Michael314as/Exoskelett/docs/kraftverteilung.md

# Kraftverteilung (Entwurf 4)

Grobe statische Abschätzung: Welche Kräfte entstehen beim Aufladen und Schleifen, über welche
Teile laufen sie in den Boden und wie viel davon kann das Exo übernehmen.
Gerechnet mit [`tools/kraftverteilung.py`](../tools/kraftverteilung.py) (Seitenansicht, ohne
Schwung, Baumgewichte „typische Nordmanntanne“; echte Bäume streuen stark).

Die Zahlen sind **Größenordnungen** für die Auslegung, keine Vorhersage für jeden Baum.

---

## 1. Kraftfluss: welcher Weg die Last nimmt

```
Stamm
 └─ Zahnleiste + Schlaufen am Handgelenk (rechts 2, links 1)
     └─ Schlaufenkopf (Alu, an der Unterarmschiene verschraubt)
         └─ Unterarmschiene ── Ellbogengelenk (Motor über Bowdenzug-Paar)
             └─ Oberarmschiene ── Schultergelenk (Motor über offenes Seilpaar)
                 └─ Schulterbügel ── Rückenrahmen
                     └─ Hüftbügel ── Hüftgelenk (Motor über Beinseil)
                         └─ Oberschenkelschiene ── Kniegelenk (gleiches Beinseil)
                             └─ Unterschenkelschiene ── Sprunggelenk (frei)
                                 └─ Steigbügel unter dem Schuh ── Boden
```

Wichtig für die Steuerung: **Die blauen Manschetten liegen nicht in diesem Weg.** Die Last des
Baums geht über die Schlaufen direkt in die Schienen. Die Manschetten spüren nur, was dein
Körper gegen das Exo drückt – also deine Absicht. Dazu mehr in [steuerung.md](steuerung.md).

Wo die Last am Körper ankommt:
- **Hüftgurt:** nimmt das Gewicht von Rahmen, Akku und Motoren (rund 10 kg) und, wenn die
  Beinmotoren nicht schieben, auch die Last aus den Armen.
- **Exo-Beine:** bei fast gestreckten Knien tragen die Schienen die Last fast ohne Motorkraft
  in den Steigbügel. In der Hocke trägt nur, was die Beinmotoren an Moment aufbringen.
- **Deine Arme** spüren nur den Teil, den das Exo nicht übernimmt.

---

## 2. Lasten je Arbeitsschritt

„Kraft je Arm“ ist die Kraft am stärker belasteten Arm, „je Schlaufe“ teilt sie rechts auf zwei
Schlaufen, links auf eine (beim Aufrichten hebelt links die Hand). Momente sind die **Zusatzmomente durch den Baum** (das Eigengewicht von Körper und
Exo kommt dazu). „Schwerpunkt vor Knöchel“: Liegt der Wert über etwa 20 cm, kippt man ohne
Ausfallschritt nach vorne (Schuh reicht etwa 20 cm vor den Knöchel).

| Schritt | Baum | Kraft je Arm (N) | je Schlaufe (N) | Ellbogen je Arm (Nm) | Schulter je Arm (Nm) | Hüfte beide (Nm) | Knie beide (Nm) | Schwerpunkt vor Knöchel (cm) |
| --- | --- | --- | --- | --- | --- | --- | --- | --- |
| Aufrichten 2 m | 15 kg | 92 | 92 | 27 | 28 | 54 | 33 | 9 |
| Aufrichten 3 m | 41 kg | 361 | 361 | 104 | 108 | 212 | 129 | 21 |
| Aufrichten 4 m | 85 kg | 960 | 960 | 277 | 288 | 564 | 343 | 35 |
| Tragen 2 m | 15 kg | 147 | 74 | 15 | 37 | 21 | 6 | -3 |
| Tragen 3 m | 41 kg | 402 | 201 | 42 | 101 | 57 | 17 | -1 |
| Tragen 4 m | 85 kg | 834 | 417 | 87 | 208 | 118 | 35 | 0 |
| Hochheben 2 m | 15 kg | 147 | 74 | 30 | 47 | 29 | 17 | -2 |
| Hochheben 3 m | 41 kg | 402 | 201 | 83 | 129 | 78 | 47 | 1 |
| Hochheben 4 m | 85 kg | 834 | 417 | 171 | 267 | 162 | 97 | 3 |
| Schleifen 2 × 2 m | 15 kg | 107 | 53 | 19 | 11 | 13 | 23 | -4 |
| Schleifen 3 × 2 m | 15 kg | 213 | 107 | 39 | 23 | 19 | 35 | -6 |
| Schleifen 2 × 3 m | 41 kg | 296 | 148 | 52 | 28 | 35 | 60 | -9 |

Annahmen der Schritte:
- **Aufrichten:** Schnittende steht am Boden (Drehpunkt), linker Unterarm hebt etwa 90 cm weiter
  oben, Baum bei 15°. Hocke, Rumpf vorgeneigt.
- **Tragen:** Baum fast senkrecht, rechter Unterarm steil nach oben wie eine Fackel, linker stützt nur seitlich.
- **Hochheben:** Schnittende auf etwa Brusthöhe.
- **Schleifen:** Arme hängen, Stümpfe am Handgelenk (rechts bis zu zwei, links einer), Spitzen schleifen über nassen Schnee
  oder Schlamm (Reibwert 0,7, eher hoch angesetzt).

---

## 3. Was die Antriebe schaffen

Motor-Klasse „Robotergelenk mittel“ (etwa 9 Nm dauernd, 25 Nm Spitze am Abtrieb), Seiltrommel
Ø 3 cm. Je Körperseite, nach Reibungsverlusten (Bowdenzug 30 %, offenes Seil über Rollen 10–12 %):

| Gelenk | Übersetzung | Dauer (Nm) | Spitze (Nm) |
| --- | --- | --- | --- |
| Schulter | Seilscheibe Ø 14 cm, offenes Seilpaar | 37 | 103 |
| Ellbogen | Seilscheibe Ø 10 cm, Bowdenzug-Paar | 21 | 58 |
| Hüfte | eigener Motor an der Hüftschwinge, Seilgetriebe 1:6 (Trommel Ø 2 / Scheibe Ø 12 cm) | 47 | 140 |
| Knie | Bowdenzug-Paar, Kurvenscheibe 5 cm gestreckt bis 8 cm in der Hocke | 21–31 | 58–95 (gestreckt) bis 115 (Hocke, Spitze) |

### Entwurf 4: Mischweg an der Hüfte (gerechnet und entschieden)

Bedarf je Seite in tiefer Hocke beim Aufrichten eines 3-m-Baums: Hüfte etwa 45 Nm (Körper) + 106 Nm (Baum) ≈ 150 Nm,
Knie etwa 33 + 65 ≈ 100 Nm. Soll das Exo die Hälfte tragen: Hüfte ≈ 75 Nm, Knie ≈ 50 Nm.

| | ein Seil pro Bein (Entwurf 3.2) | Mischweg (Entwurf 4) |
|---|---|---|
| Hüfte Spitze | ~140 Nm | ~140 Nm |
| Knie Spitze | ~120 Nm | ~95–115 Nm |
| Hüfte und Knie getrennt regelbar | nein (festes Verhältnis 1,2 : 1) | **ja** |
| Spreizen | Seile durch hohle Achse, 4 Umlenkrollen | Motor spreizt mit, nur ein biegsamer Bowdenzug fürs Knie |
| Motoren | 6 | 8 (+300 bis 1 000 €, +1,5 bis 2 kg nah am Schwerpunkt) |

Entscheidend war nicht die Kraft (beide Wege reichen), sondern dass Hüfte und Knie in beide Richtungen getrennt geregelt
werden können: Nur so läuft das Bein beim Gehen frei mit und das Exo-Bein lässt sich je Gelenk sauber ausgleichen.
Ein Hüftmotor ohne Seilgetriebe reicht nicht (25 Nm); ein Motor mit großem Getriebe wäre stark genug, ließe sich aber
nicht mehr leicht von Hand bewegen.

Gegenüber Entwurf 3 bringt die neue Seilführung an der Schulter rund 25 % mehr (offenes Seil statt Bowdenzug) und
am Knie in der Hocke rund 33 % mehr (Kurvenscheibe statt fester Rolle), ohne stärkere Motoren. Dazu kommt das Seil
nicht mehr an die Gelenke: Vorher lief es in tiefer Hocke durch das Kniegelenk, und der Hebel an der Hüfte schrumpfte.

Seilkraft bei Motorspitze: etwa 1.700 N. Dyneema 3 mm hält ein Vielfaches; Bowden-Innenzug
deshalb **2 mm Edelstahl 7 × 7 oder Dyneema in PTFE-Hülle**, Software begrenzt auf etwa 1.000 N.

### Bewertung

| Bereich | 2 m | 3 m | 4 m |
| --- | --- | --- | --- |
| Schultern | Exo kann alles übernehmen | Exo übernimmt fast alles bis drei Viertel | Exo hilft spürbar (rund ein Drittel bis die Hälfte), Rest du |
| Ellbogen | Exo kann alles übernehmen | beim Tragen fast alles, beim Aufrichten gut die Hälfte | ein Fünftel (Aufrichten) bis zwei Drittel (Tragen) |
| Hüfte, Knie | locker | Exo übernimmt die Hälfte oder mehr | beim Aufrichten etwa die Hälfte, beim Tragen das meiste |
| Schleifen | kaum Moment, Last hängt an den Schultern | dito | dito |

Daraus folgt:
1. **Die Schultern sind der Engpass**, sobald der Baum vor dem Körper hängt. Weil der Stamm jetzt als
   Verlängerung des Unterarms am Handgelenk hängt, trägt man ihn am besten mit **steil aufgerichtetem
   Unterarm, wie eine Fackel**: Dann drückt die Last fast längs durch Unterarm und Ellbogen, und der
   Ellbogen muss kaum Moment halten. Möglichst nah am Körper; die linke Hand stützt weiter oben.
   Beim Aufrichten (Unterarm flach) ist dagegen der Ellbogen stark gefordert, dort helfen die Beine.
2. **Beine und Hüfte** sind gut versorgt. Das ist gewollt: Aufrichten und Hochheben kommen am
   besten aus den Beinen, wie beim richtigen Heben.
3. **Schleifen ist für das Exo leicht:** Mit hängenden Armen zieht die Last fast nur in
   Längsrichtung an den Schienen, die Gelenke müssen kaum Moment halten. Die Last landet über
   den Rahmen auf Hüftgurt und Exo-Beinen statt auf deinen Schultern.
4. **Gleichgewicht:** Beim Aufrichten schwerer Bäume (3–4 m) liegt der Schwerpunkt vor der
   Schuhspitze. Ohne verlängerte Fußplatten heißt das: **Ausfallschritt**, also einen Fuß nach vorne,
   und mit den Beinen hochdrücken. Das macht man ohnehin intuitiv. Beim Tragen, Hochheben und
   Schleifen bleibt der Schwerpunkt über dem Fuß.
5. **Schlaufen:** typisch 50–200 N je Schlaufe, im Extremfall rund 500 N (rechts verteilt auf zwei
   Schlaufen). Mit Zahnleiste im Schlaufenkopf hält der Stamm formschlüssig und nicht nur über Reibung.

---

## 4. Wie viel spürst du noch?

Die Steuerung verstärkt deine Kraft mit einem einstellbaren Faktor K (siehe
[steuerung.md](steuerung.md)). Solange die Motoren nicht an ihrer Grenze sind, gilt:

| K | Exo übernimmt | du spürst |
| --- | --- | --- |
| 0,5 | ein Drittel | zwei Drittel |
| 1 | die Hälfte („doppelte Kraft“) | die Hälfte |
| 2 | zwei Drittel | ein Drittel |
| 3 | drei Viertel | ein Viertel |

Start mit K = 0,5, dann steigern. Über K = 3 wird das Exo unruhig und man spürt die Last
kaum noch, was gefährlich ist: Man merkt nicht mehr, wenn etwas zu schwer wird.

---

## 5. Folgen für die Konstruktion

- Schulter- und Ellbogengelenke mit **großer Seilscheibe** (Ø 10–14 cm), Schulter mit offenem Seilpaar,
  weil dort am meisten Moment gebraucht wird. Bowdenzug nur dort, wo ein Seil über mehrere bewegte
  Gelenke müsste (Ellbogen).
- **Seilscheiben auf den Gelenkachsen** statt Rollen daneben: konstanter Hebel, das Seil kommt nie ans
  Gelenk. Am Knie eine Kurvenscheibe, die in der Hocke den größten Hebel gibt.
- Jede Rolle kostet ein paar Prozent: so wenige wie möglich, Kugellager, Durchmesser mindestens
  10 × Seildicke.
- Schlaufenkopf und Unterarmschiene **biegesteif** (Alu 25 × 25 × 2), denn bis zu rund 1.000 N greifen
  hier außermittig an.
- Schulterbügel und Rahmen-Eckverbindungen mit **Doppelplatten**, dort sammelt sich die Last
  beider Arme.
- Hüftgurt wie bei einer Lastenkraxe: Er muss beim Schleifen 20–45 kg zusätzlich aufnehmen
  können, wenn die Beinmotoren aus sind.
- Steigbügel unter der **Schuhmitte** (nicht unter der Ferse), damit die Last der Schienen dort ankommt,
  wo du ohnehin stehst.
