Michael314as/Exoskelett/docs/wartung.md

# Wartung

Die Firmware zählt die Betriebsstunden und meldet in der Statuszeile bzw. in der Konsole (`status`), wenn etwas fällig ist.

| Wann | Was | Wie |
|---|---|---|
| vor jedem Einsatz | Sichtprüfung | Seile ohne Scheuerstellen, Schnallen, Spikes fest, Not-Aus kurz testen |
| nach jedem Einsatz | trocknen | Box öffnen, Polster abnehmen und trocknen, Harz abwischen |
| alle 40 h | Seile und Bowdenzüge | auf Abrieb prüfen, Vorspannung nachstellen, Rollen auf Leichtgang prüfen |
| alle 40 h | Schrauben | Gelenk-Passschrauben mit Drehmomentschlüssel nachziehen (M10: 20 Nm, M6: 8 Nm) |
| alle 100 h | Wägezellen | Nullpunkt und ein Kalibriergewicht prüfen (`null`, `kal`) |
| alle 200 h oder jährlich | Inspektion | Beinseile tauschen, Lager prüfen (Spiel, Geräusch), Schlaufenschläuche tauschen, Prüfprotokoll P5–P20 wiederholen |
| bei Bedarf | Spikes | auf hartem Boden abschrauben, stumpfe tauschen |

**Verschleißteile auf Vorrat:** 10 m Dyneema 3 mm, 2 Bowden-Innenzüge, 3 Schlaufenschläuche, 10 Spikes, 4 Gummipuffer.
