Michael314as/Exoskelett/fertigung/druck/manschette_schienbein.stl

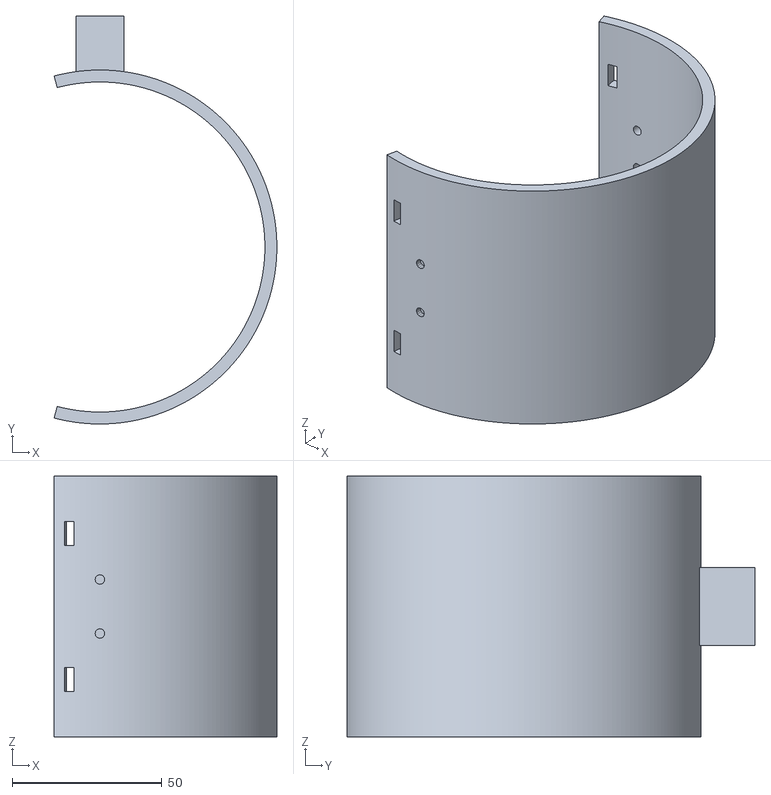
[picture p1: CAD file, 2026-11-03]
fertigung/druck/manschette_schienbein.stl
74.3 x 136.0 x 87.0
