Michael314as/Exoskelett/fertigung/laser/manschette_schlitten.dxf

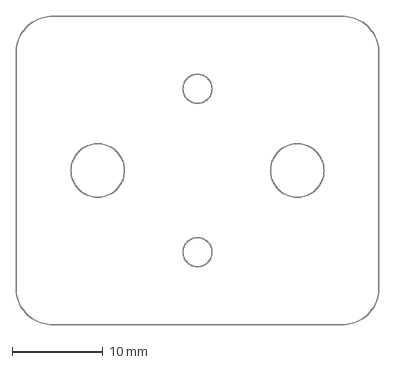
[picture p2: CAD file, 2026-11-03]
fertigung/laser/manschette_schlitten.dxf
40.0 x 34.0 mm
