Michael314as/Exoskelett/fertigung/druck/manschette_oberschenkel.stl

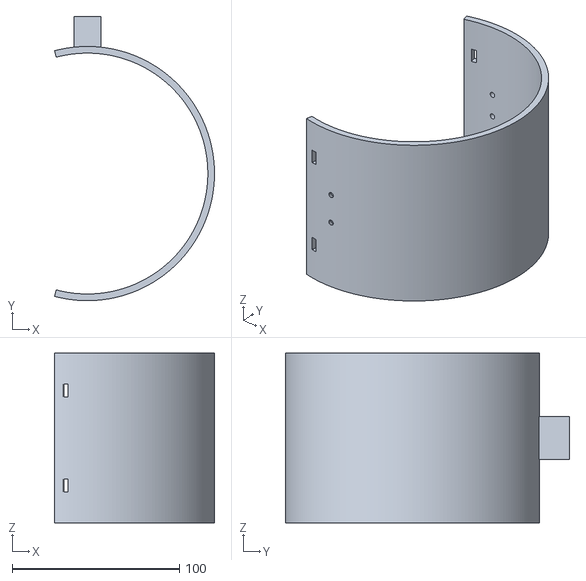
[picture p3: CAD file, 2026-11-03]
fertigung/druck/manschette_oberschenkel.stl
95.7 x 170.0 x 101.5
