Michael314as/Exoskelett/fertigung/laser/manschette_stangenhalter.dxf

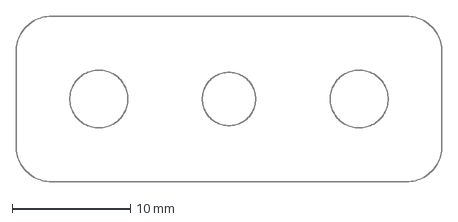
[picture p4: CAD file, 2026-11-03]
fertigung/laser/manschette_stangenhalter.dxf
36.0 x 14.0 mm
