Michael314as/Exoskelett/fertigung/druck/manschette_oberarm.stl

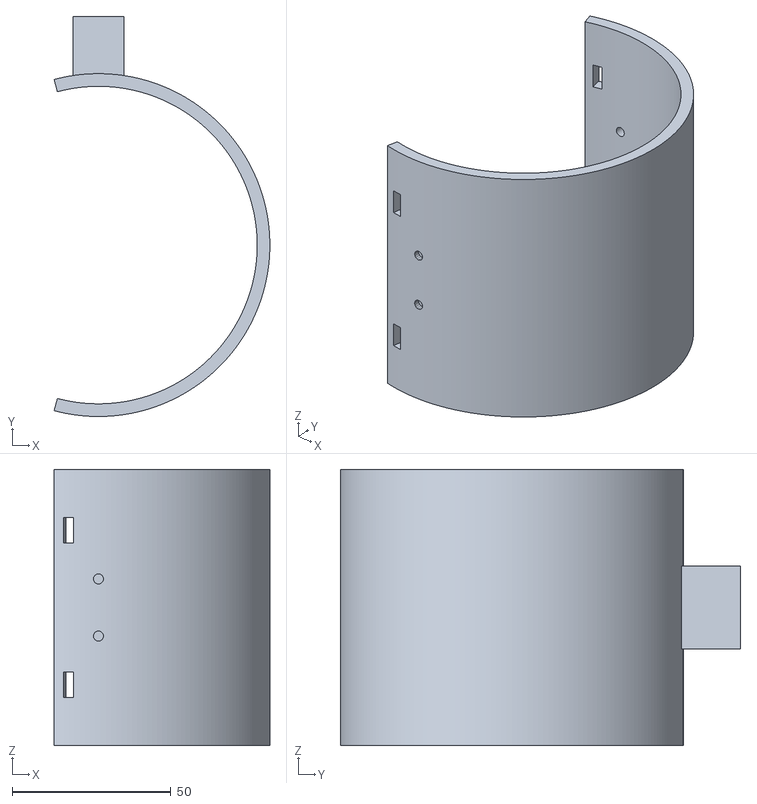
[picture p5: CAD file, 2026-11-03]
fertigung/druck/manschette_oberarm.stl
68.0 x 126.0 x 87.0
