Michael314as/Exoskelett/fertigung/laser/kniehebel.dxf

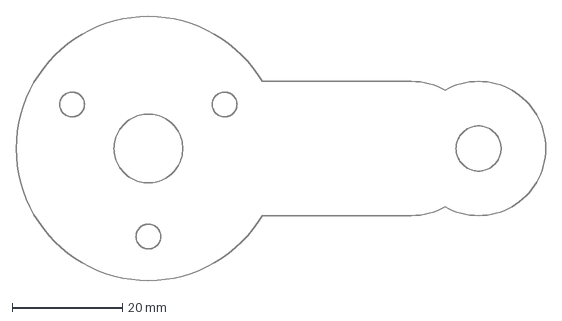
[picture p6: CAD file, 2026-11-02]
fertigung/laser/kniehebel.dxf
96.2 x 48.0 mm
