Michael314as/Exoskelett/fertigung/druck/manschette_unterarm.stl

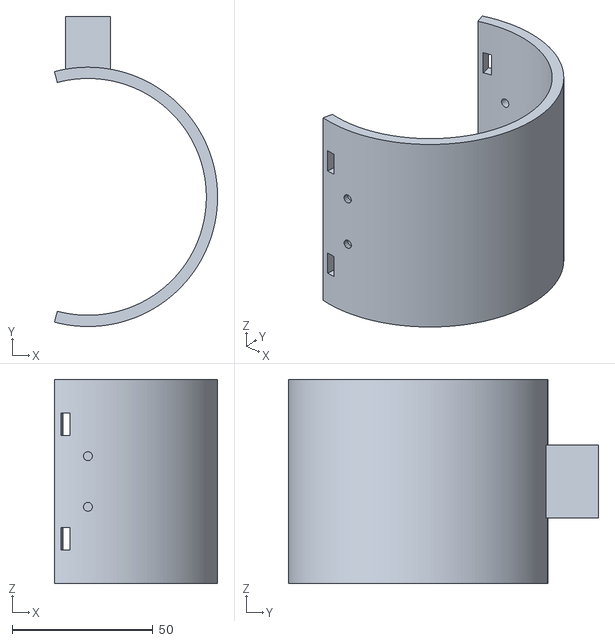
[picture p7: CAD file, 2026-11-03]
fertigung/druck/manschette_unterarm.stl
57.9 x 110.0 x 72.5
