Michael314as/Exoskelett/fertigung/laser/fersenbuegel_lasche.dxf

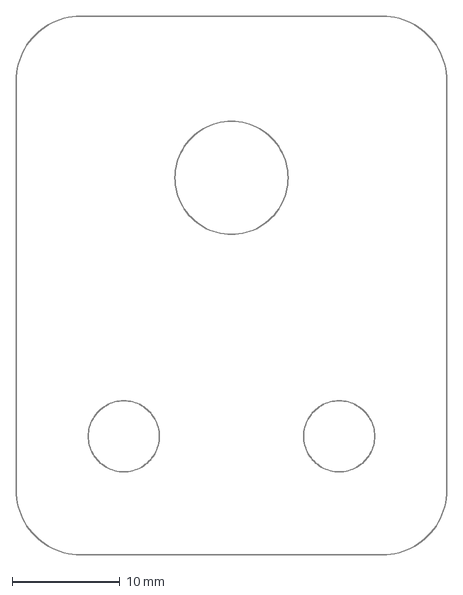
[picture p8: CAD file, 2026-11-02]
fertigung/laser/fersenbuegel_lasche.dxf
40.0 x 50.0 mm
