Michael314as/Exoskelett/fertigung/druck/haube_rechts.stl

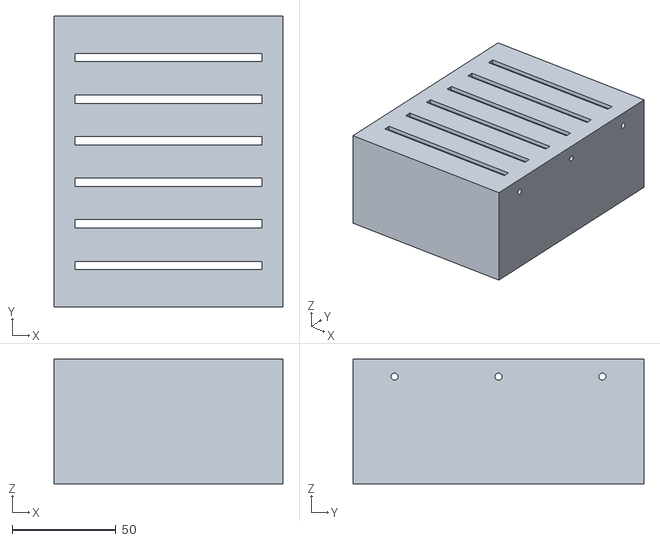
[picture p9: CAD file, 2026-11-02]
fertigung/druck/haube_rechts.stl
110.0 x 140.0 x 60.0
