Michael314as/Exoskelett/fertigung/laser/kurbel_rumpf_beugen.dxf

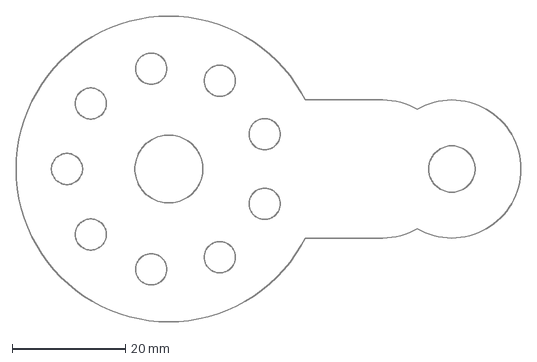
[picture p10: CAD file, 2026-11-02]
fertigung/laser/kurbel_rumpf_beugen.dxf
89.2 x 54.0 mm
