Michael314as/Exoskelett/fertigung/druck/haube_links.stl

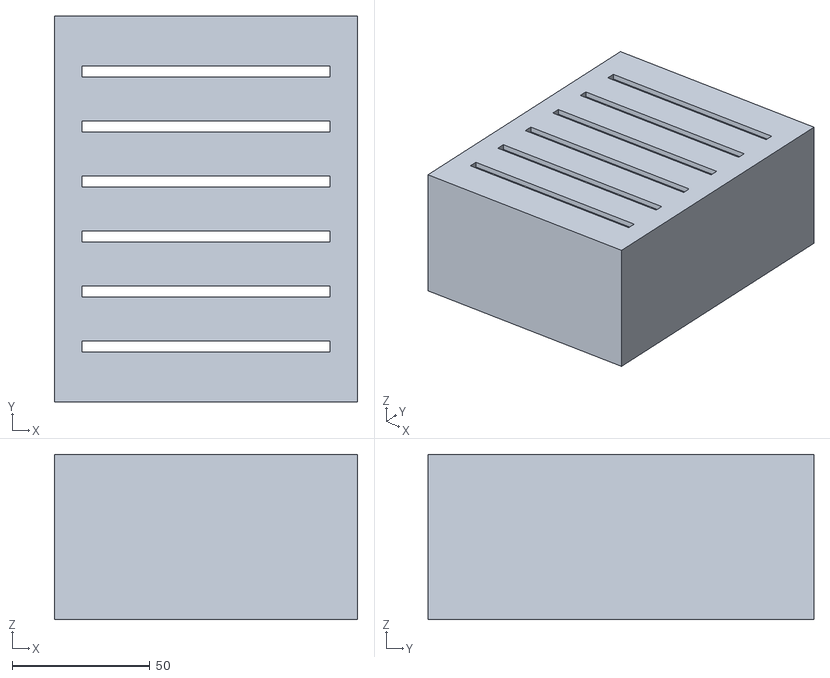
[picture p11: CAD file, 2026-11-02]
fertigung/druck/haube_links.stl
110.0 x 140.0 x 60.0
