Michael314as/Exoskelett/fertigung/laser/traeger_rumpfkapsel.dxf

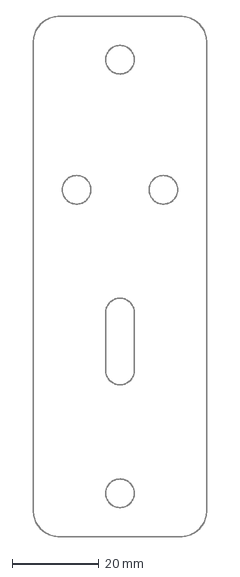
[picture p12: CAD file, 2026-11-02]
fertigung/laser/traeger_rumpfkapsel.dxf
40.0 x 120.0 mm
