Michael314as/Exoskelett/fertigung/druck/bohrschablone_kuehlkoerper_rs04.stl

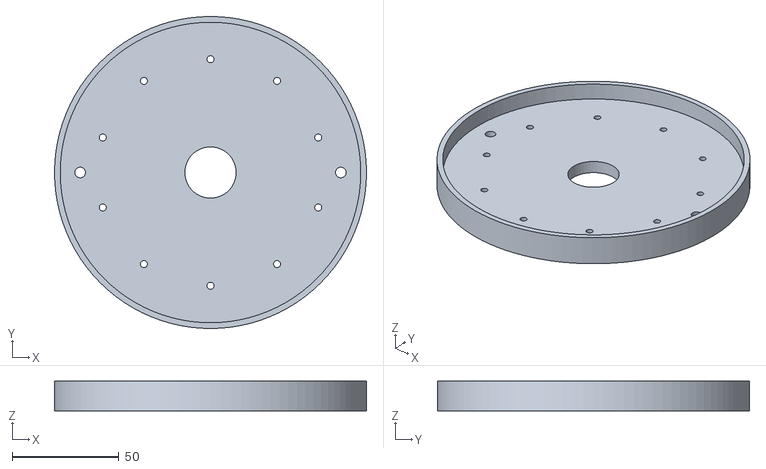
[picture p13: CAD file, 2026-11-02]
fertigung/druck/bohrschablone_kuehlkoerper_rs04.stl
146.0 x 146.0 x 14.0
