Michael314as/Exoskelett/fertigung/laser/rumpfdrehung_wagen.dxf

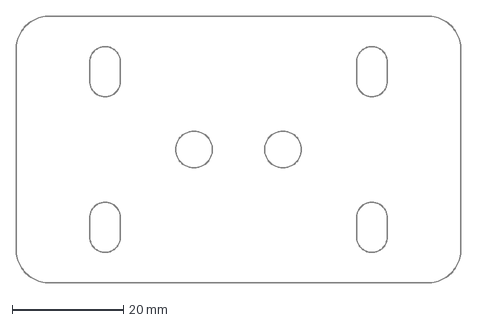
[picture p14: CAD file, 2026-11-02]
fertigung/laser/rumpfdrehung_wagen.dxf
80.0 x 48.0 mm
