Michael314as/Exoskelett/fertigung/druck/kapselmantel_rs04.stl

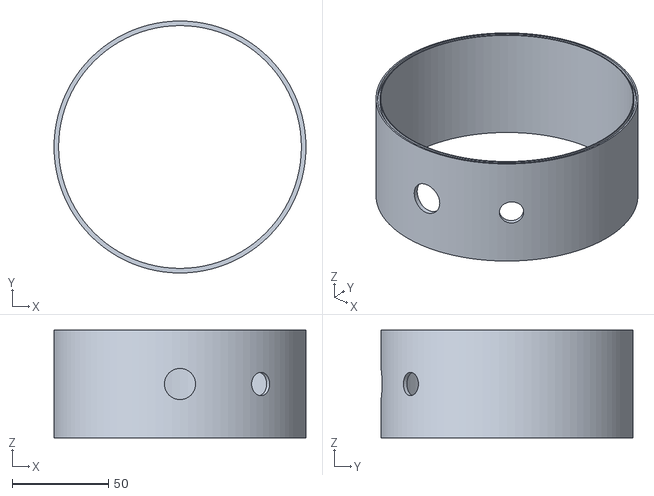
[picture p15: CAD file, 2026-11-02]
fertigung/druck/kapselmantel_rs04.stl
130.8 x 130.8 x 56.0
