Michael314as/Exoskelett/fertigung/laser/steigbuegel.dxf

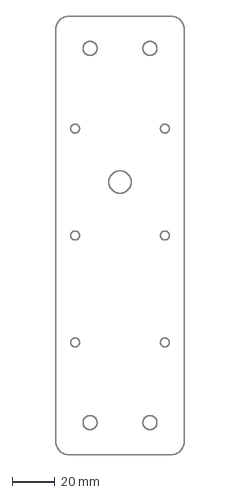
[picture p16: CAD file, 2026-11-02]
fertigung/laser/steigbuegel.dxf
60.0 x 205.0 mm
