Michael314as/Exoskelett/fertigung/druck/kapselmantel_rs03.stl

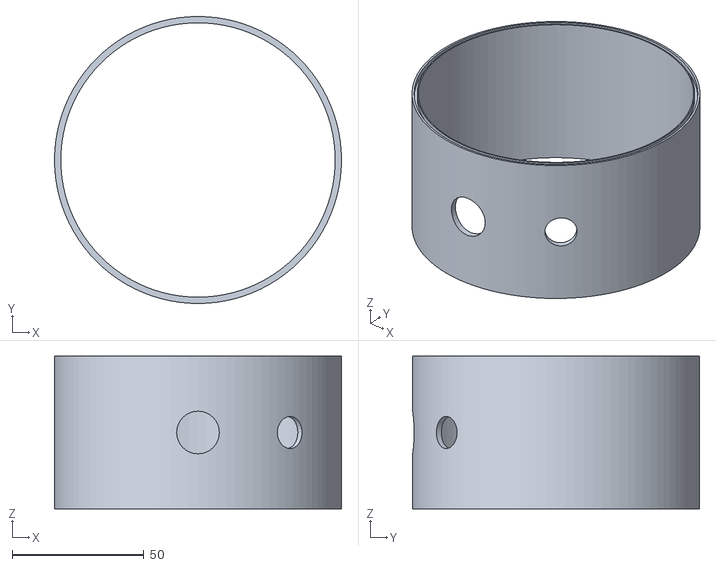
[picture p17: CAD file, 2026-11-02]
fertigung/druck/kapselmantel_rs03.stl
108.8 x 108.8 x 58.0
