Michael314as/Exoskelett/fertigung/laser/eckplatte.dxf

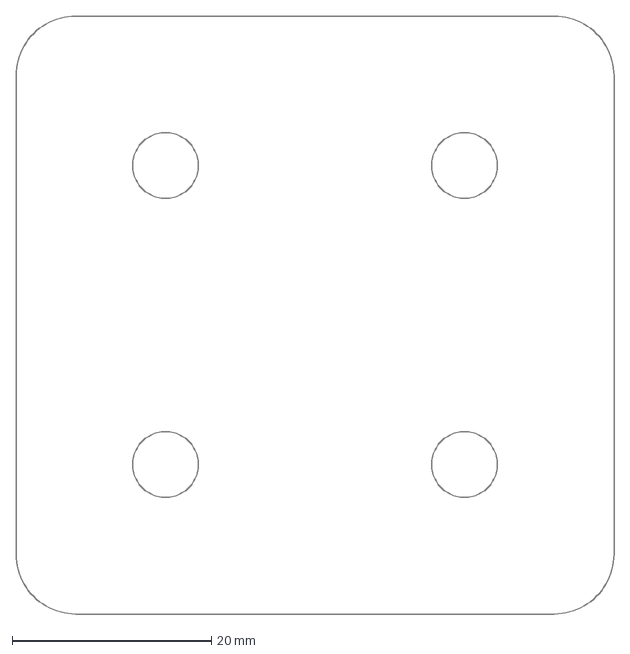
[picture p18: CAD file, 2026-11-02]
fertigung/laser/eckplatte.dxf
60.0 x 60.0 mm
