Michael314as/Exoskelett/fertigung/druck/bohrschablone_kuehlkoerper_rs03.stl

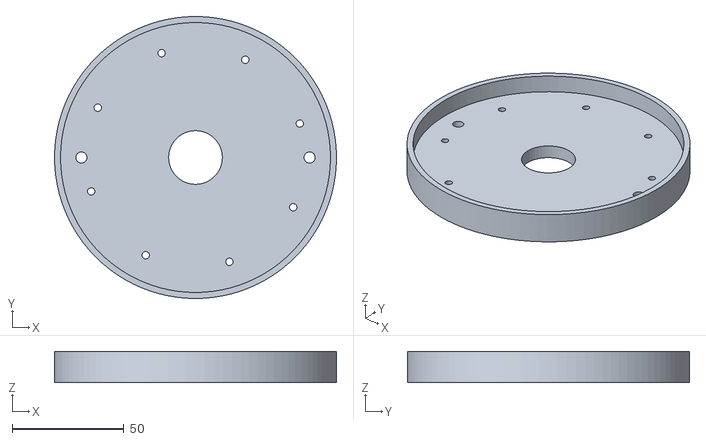
[picture p19: CAD file, 2026-11-02]
fertigung/druck/bohrschablone_kuehlkoerper_rs03.stl
126.0 x 126.0 x 14.0
