Michael314as/Exoskelett/fertigung/laser/abtriebsflansch_rs04.dxf

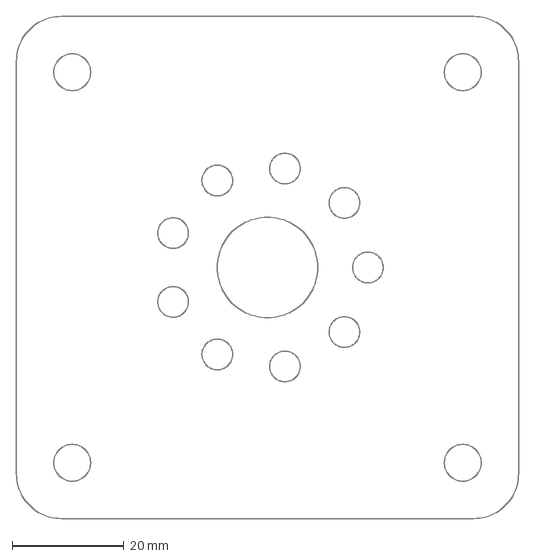
[picture p20: CAD file, 2026-11-02]
fertigung/laser/abtriebsflansch_rs04.dxf
90.0 x 90.0 mm
