Michael314as/Exoskelett/fertigung/druck/kurbelschutz_ellbogen.stl

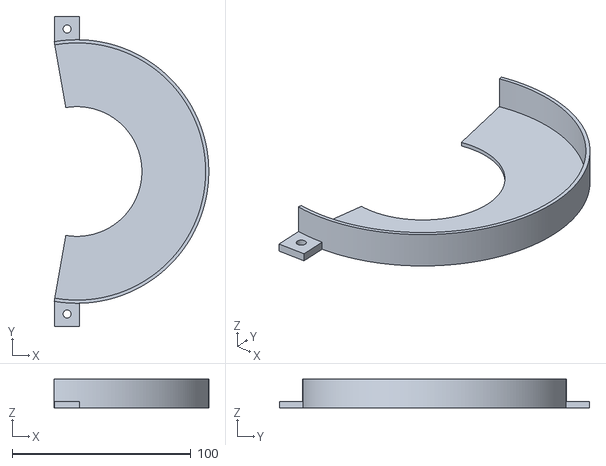
[picture p21: CAD file, 2026-11-02]
fertigung/druck/kurbelschutz_ellbogen.stl
86.6 x 173.6 x 16.0
