Michael314as/Exoskelett/fertigung/laser/kurbel_knie.dxf

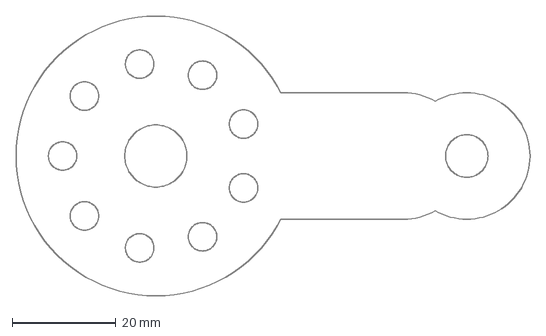
[picture p22: CAD file, 2026-11-02]
fertigung/laser/kurbel_knie.dxf
99.2 x 54.0 mm
