Michael314as/Exoskelett/fertigung/druck/kurbelschutz_knie.stl

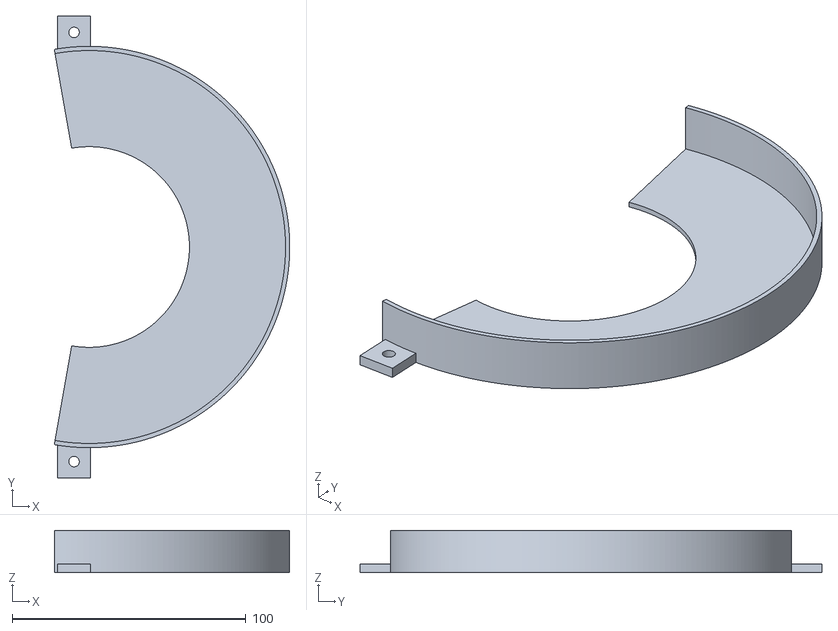
[picture p23: CAD file, 2026-11-02]
fertigung/druck/kurbelschutz_knie.stl
100.7 x 197.6 x 18.0
