Michael314as/Exoskelett/fertigung/laser/drehteller_scheibe.dxf

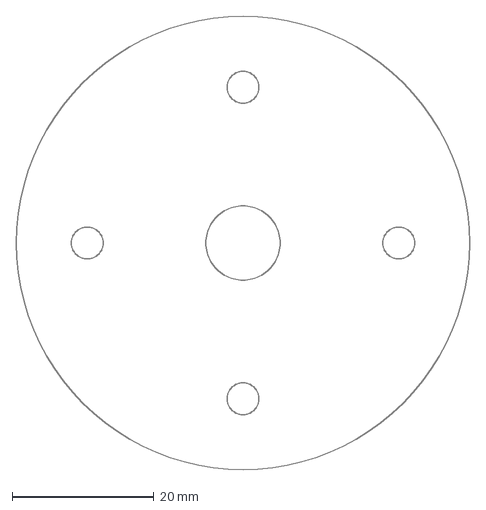
[picture p24: CAD file, 2026-11-02]
fertigung/laser/drehteller_scheibe.dxf
64.0 x 64.0 mm
