Michael314as/Exoskelett/fertigung/druck/akkuschacht_stirn.stl

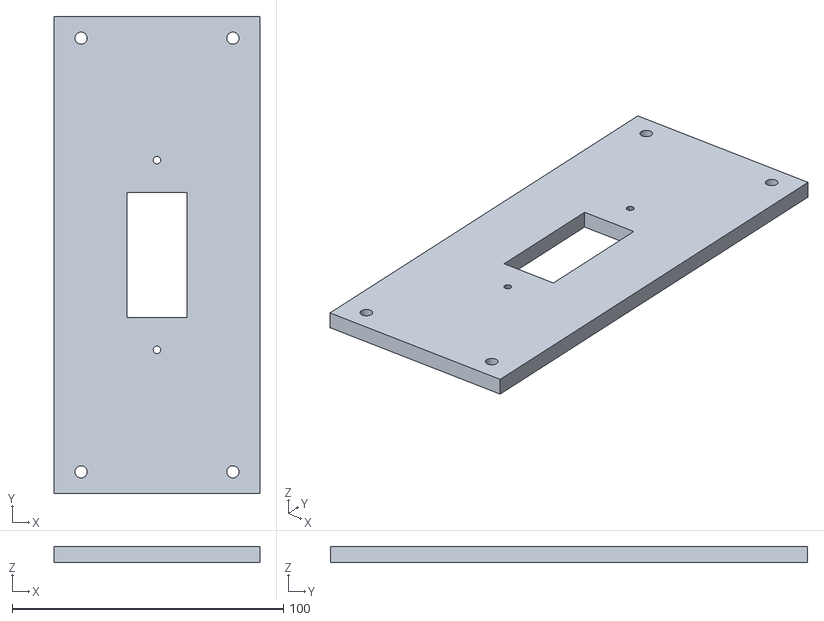
[picture p25: CAD file, 2026-11-02]
fertigung/druck/akkuschacht_stirn.stl
76.0 x 176.0 x 6.00
