Michael314as/Exoskelett/fertigung/laser/motortraeger_wange.dxf

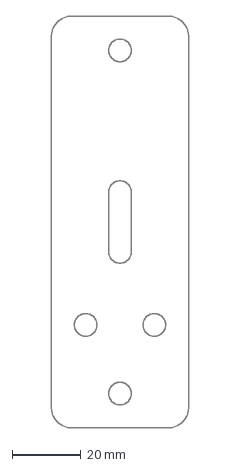
[picture p26: CAD file, 2026-11-02]
fertigung/laser/motortraeger_wange.dxf
40.0 x 120.0 mm
