Michael314as/Exoskelett/fertigung/druck/fersenschale.stl

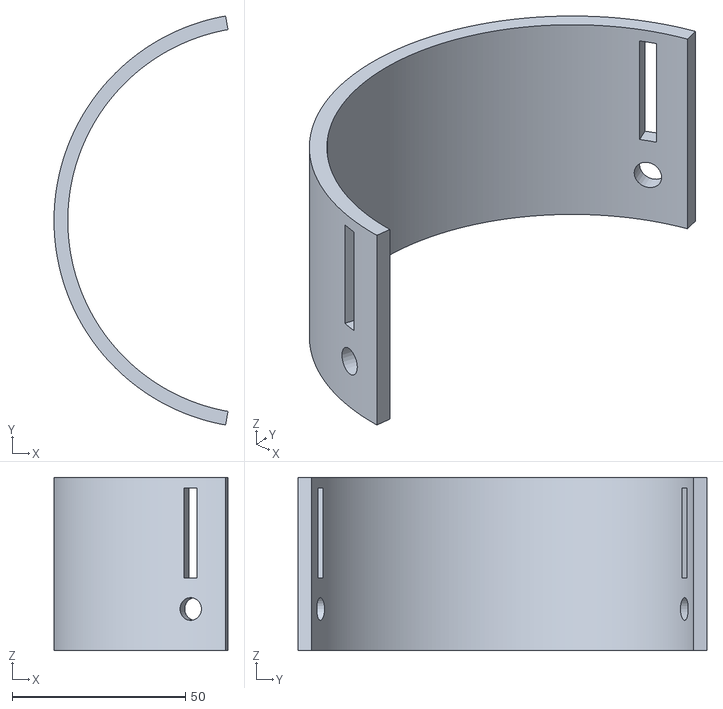
[picture p27: CAD file, 2026-11-02]
fertigung/druck/fersenschale.stl
50.3 x 118.2 x 50.0
