Michael314as/Exoskelett/fertigung/laser/lagerplatte_kfl08.dxf

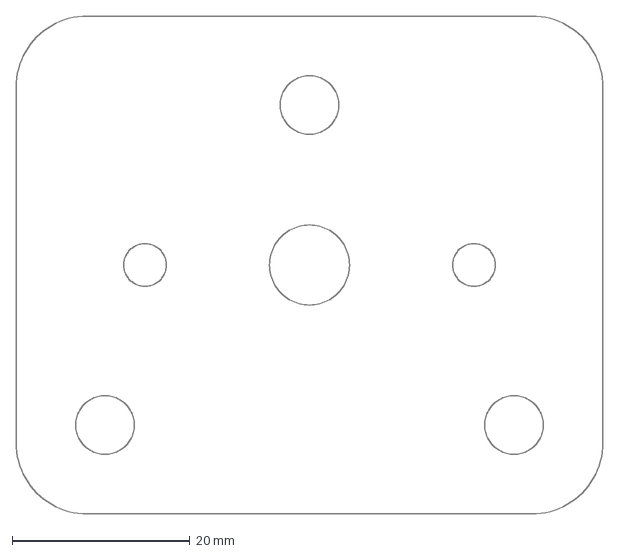
[picture p28: CAD file, 2026-11-02]
fertigung/laser/lagerplatte_kfl08.dxf
66.0 x 56.0 mm
