Michael314as/Exoskelett/fertigung/druck/akkuschacht_wand.stl

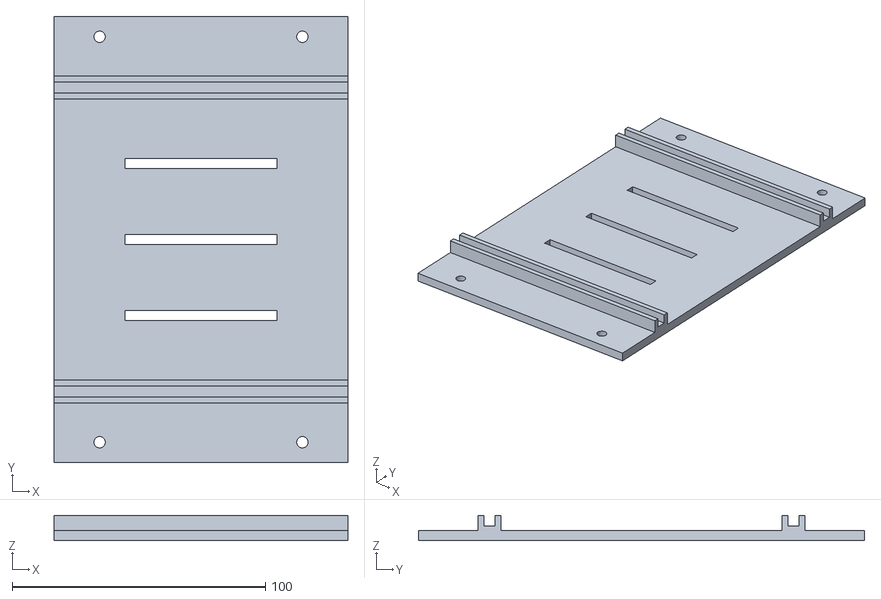
[picture p29: CAD file, 2026-11-02]
fertigung/druck/akkuschacht_wand.stl
116.0 x 176.0 x 10.0
