Michael314as/Exoskelett/fertigung/laser/lendengelenk_lasche.dxf

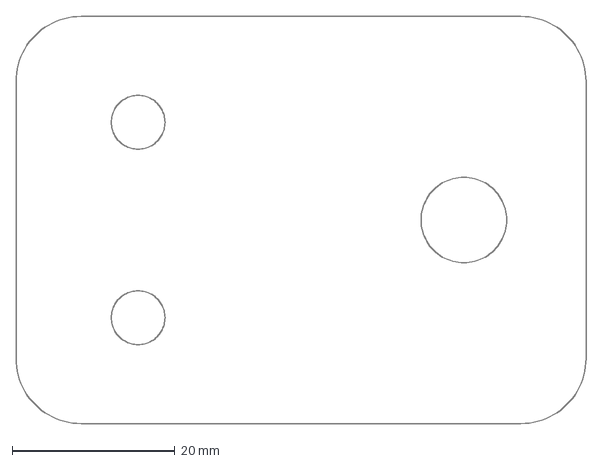
[picture p30: CAD file, 2026-11-02]
fertigung/laser/lendengelenk_lasche.dxf
70.0 x 50.0 mm
