Michael314as/Exoskelett/fertigung/druck/waegezellen_halter.stl

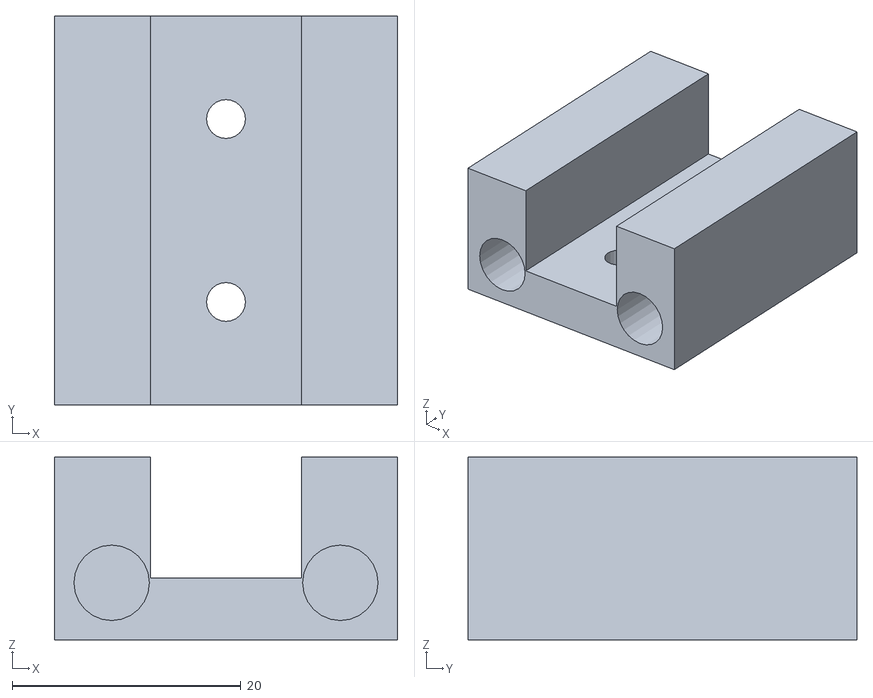
[picture p31: CAD file, 2026-10-31]
fertigung/druck/waegezellen_halter.stl
30.0 x 34.0 x 16.0
