Michael314as/Exoskelett/fertigung/laser/abspreizgabel_wange.dxf

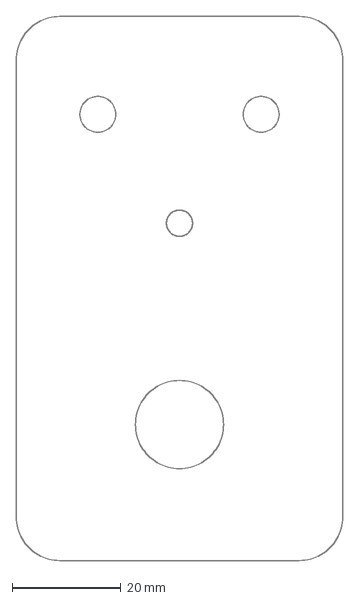
[picture p32: CAD file, 2026-11-02]
fertigung/laser/abspreizgabel_wange.dxf
60.0 x 100.0 mm
