Michael314as/Exoskelett/fertigung/druck/bohrschablone_rohr20.stl

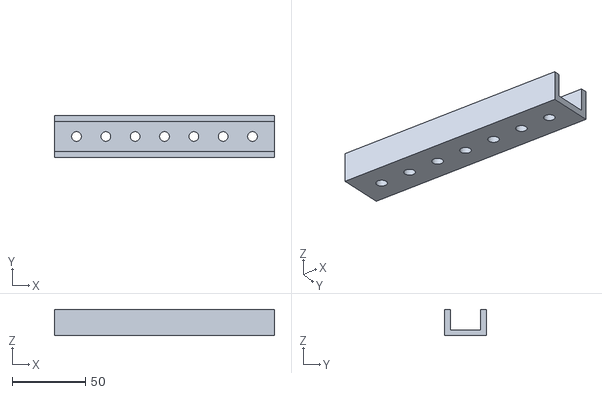
[picture p33: CAD file, 2026-10-31]
fertigung/druck/bohrschablone_rohr20.stl
150.0 x 28.6 x 18.0
