Michael314as/Exoskelett/fertigung/laser/zentrierfeder_halter.dxf

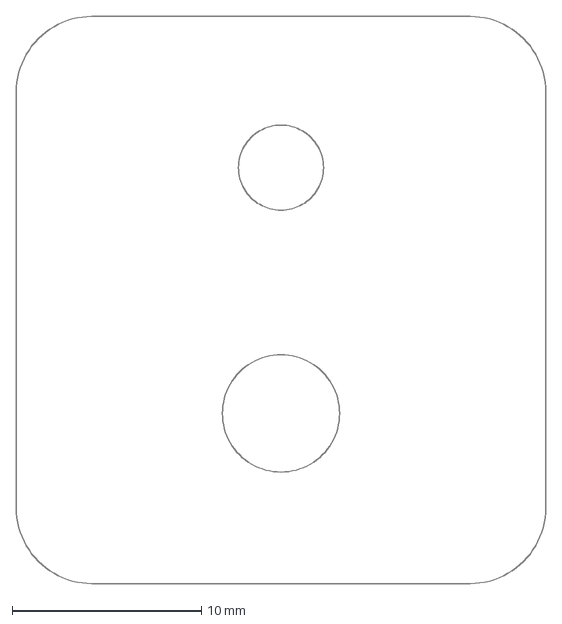
[picture p34: CAD file, 2026-11-02]
fertigung/laser/zentrierfeder_halter.dxf
28.0 x 30.0 mm
