Michael314as/Exoskelett/fertigung/druck/tastergriff_links.stl

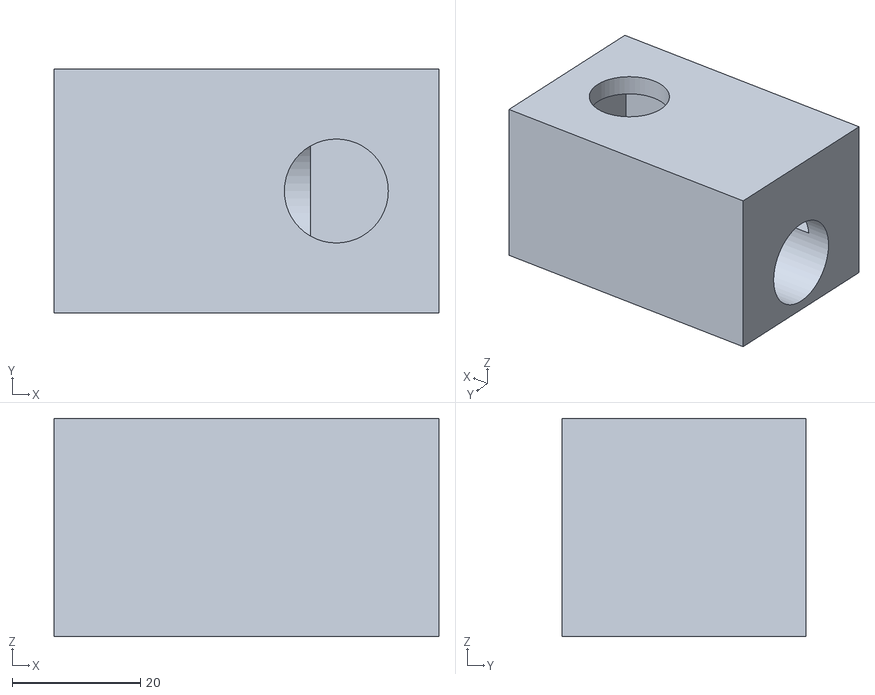
[picture p35: CAD file, 2026-10-31]
fertigung/druck/tastergriff_links.stl
60.0 x 38.0 x 34.0
