Michael314as/Exoskelett/fertigung/laser/hebel_lendengelenk.dxf

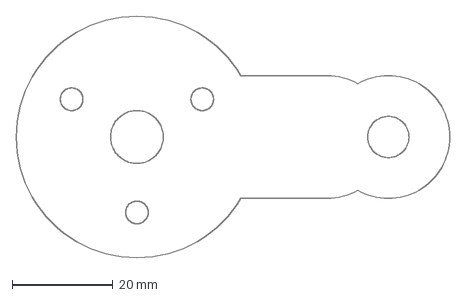
[picture p36: CAD file, 2026-11-02]
fertigung/laser/hebel_lendengelenk.dxf
86.2 x 48.0 mm
