Michael314as/Exoskelett/fertigung/druck/bohrschablone_rohr25.stl

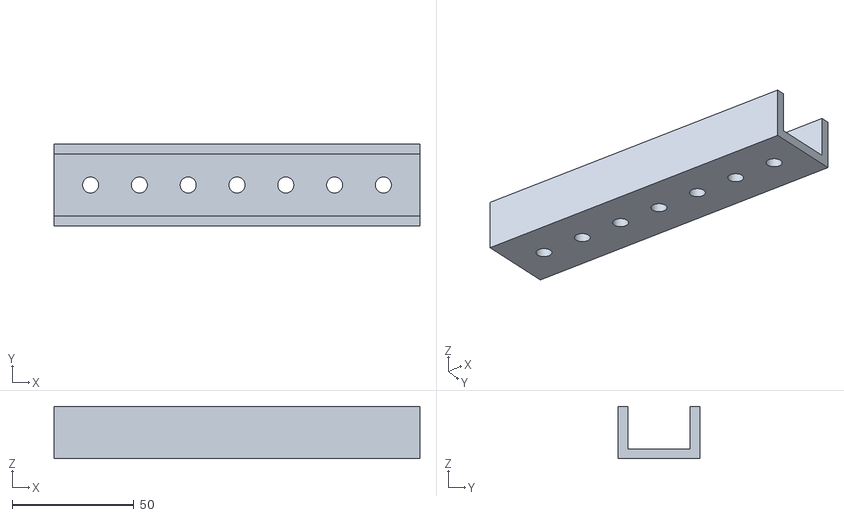
[picture p37: CAD file, 2026-10-31]
fertigung/druck/bohrschablone_rohr25.stl
150.0 x 33.6 x 21.5
