Michael314as/Exoskelett/fertigung/laser/rumpfdrehung_halter.dxf

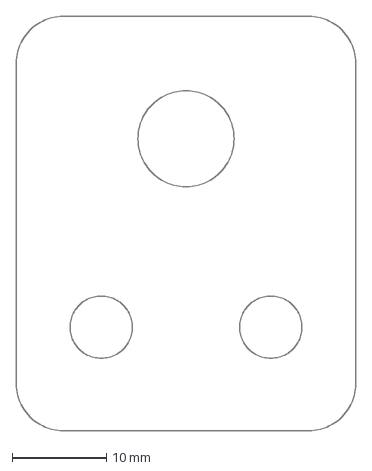
[picture p38: CAD file, 2026-11-02]
fertigung/laser/rumpfdrehung_halter.dxf
36.0 x 44.0 mm
