Michael314as/Exoskelett/fertigung/druck/ueberlastpuffer.stl

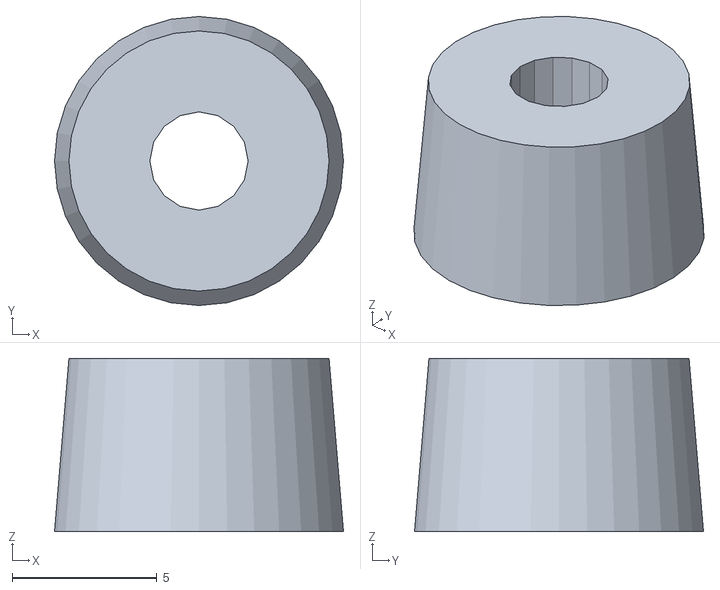
[picture p39: CAD file, 2026-10-31]
fertigung/druck/ueberlastpuffer.stl
10.0 x 10.0 x 6.00
