Michael314as/Exoskelett/fertigung/laser/kurbel_ellbogen.dxf

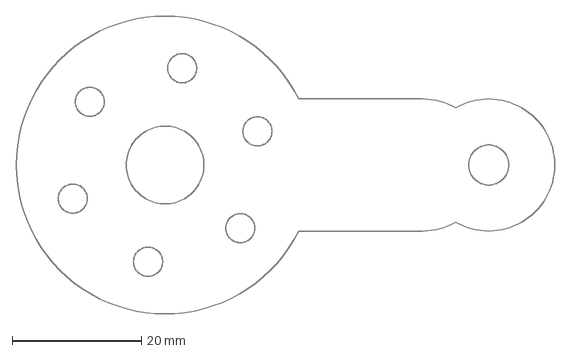
[picture p40: CAD file, 2026-11-02]
fertigung/laser/kurbel_ellbogen.dxf
83.2 x 46.0 mm
