Michael314as/Exoskelett/fertigung/laser/schulterschlitten.dxf

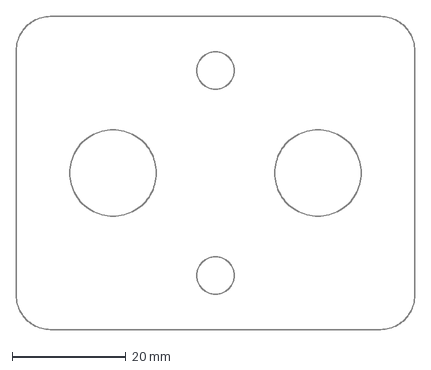
[picture p41: CAD file, 2026-11-02]
fertigung/laser/schulterschlitten.dxf
70.0 x 55.0 mm
