Michael314as/Exoskelett/fertigung/laser/ellbogenhebel.dxf

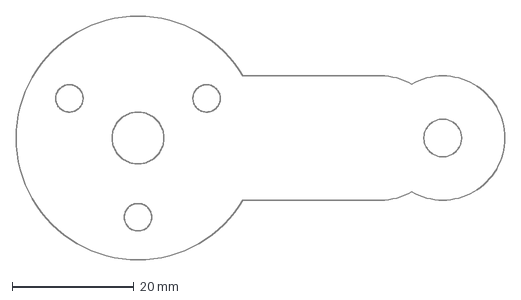
[picture p42: CAD file, 2026-11-02]
fertigung/laser/ellbogenhebel.dxf
80.2 x 40.0 mm
