Michael314as/Exoskelett/fertigung/laser/lendensperre_rastsegment.dxf

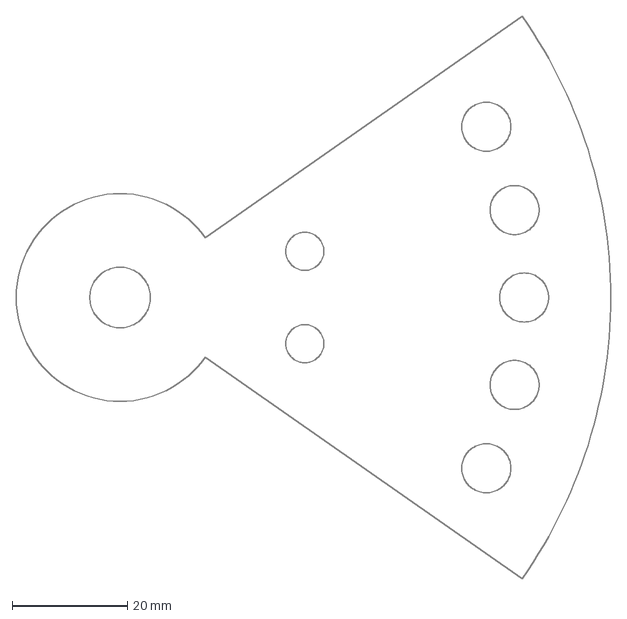
[picture p43: CAD file, 2026-11-02]
fertigung/laser/lendensperre_rastsegment.dxf
103.0 x 97.5 mm
