Michael314as/Exoskelett/fertigung/laser/gasfeder_halter.dxf

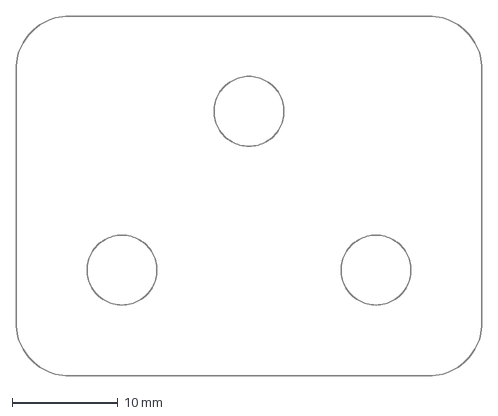
[picture p44: CAD file, 2026-11-02]
fertigung/laser/gasfeder_halter.dxf
44.0 x 34.0 mm
