Michael314as/Exoskelett/fertigung/laser/schlaufentraeger_links.dxf

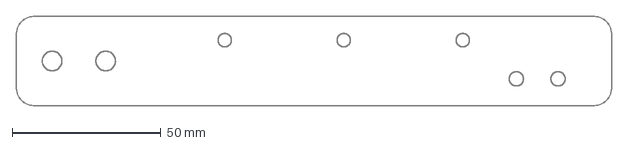
[picture p45: CAD file, 2026-11-02]
fertigung/laser/schlaufentraeger_links.dxf
200.0 x 30.0 mm
