Michael314as/Exoskelett/fertigung/laser/kurbel_rumpf_drehen.dxf

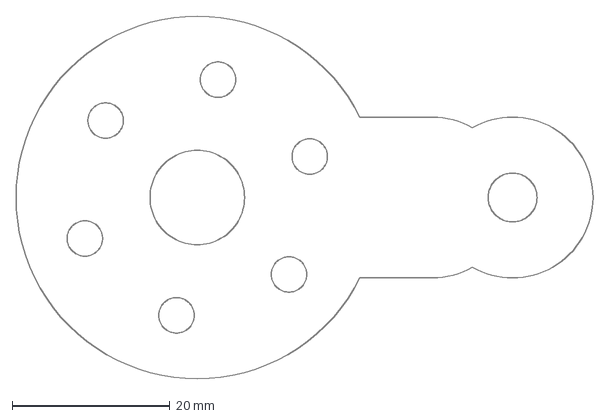
[picture p46: CAD file, 2026-11-02]
fertigung/laser/kurbel_rumpf_drehen.dxf
73.2 x 46.0 mm
