Michael314as/Exoskelett/fertigung/laser/lagerplatte_kfl002.dxf

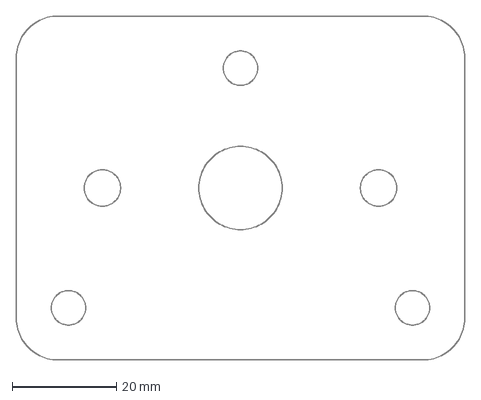
[picture p47: CAD file, 2026-11-02]
fertigung/laser/lagerplatte_kfl002.dxf
86.0 x 66.0 mm
