Michael314as/Exoskelett/fertigung/laser/parkstuetze_lasche.dxf

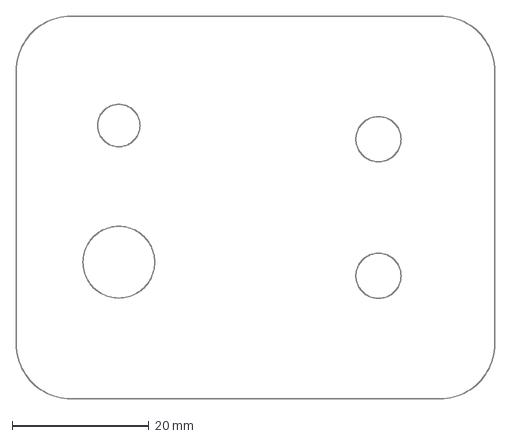
[picture p48: CAD file, 2026-11-02]
fertigung/laser/parkstuetze_lasche.dxf
70.0 x 56.0 mm
