Michael314as/Exoskelett/fertigung/laser/schultergabel_wange.dxf

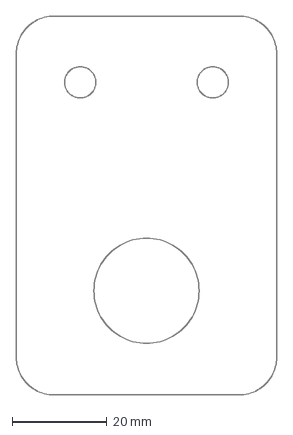
[picture p49: CAD file, 2026-11-02]
fertigung/laser/schultergabel_wange.dxf
55.0 x 80.0 mm
