Michael314as/Exoskelett/fertigung/laser/lagerplatte_kfl001.dxf

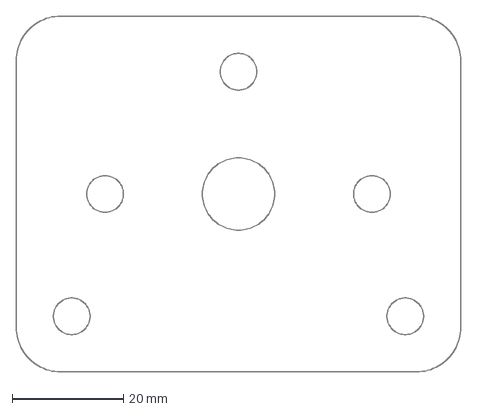
[picture p50: CAD file, 2026-11-02]
fertigung/laser/lagerplatte_kfl001.dxf
80.0 x 64.0 mm
