Michael314as/Exoskelett/fertigung/laser/schlaufentraeger_rechts.dxf

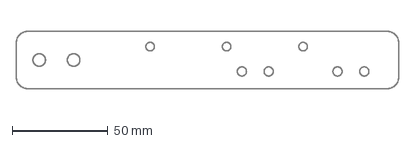
[picture p51: CAD file, 2026-11-02]
fertigung/laser/schlaufentraeger_rechts.dxf
200.0 x 30.0 mm
