Michael314as/Exoskelett/fertigung/laser/kippgelenk_gabel.dxf

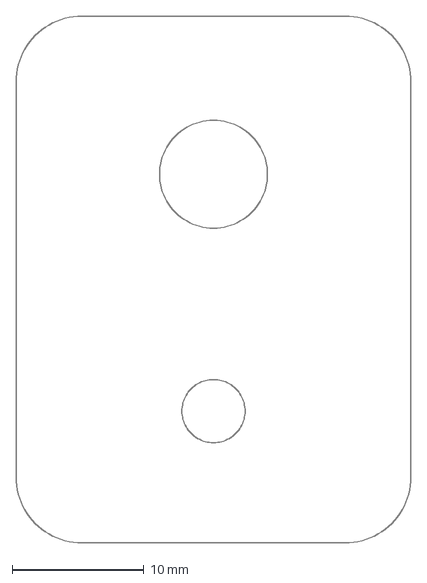
[picture p52: CAD file, 2026-11-02]
fertigung/laser/kippgelenk_gabel.dxf
30.0 x 40.0 mm
