Michael314as/Exoskelett/fertigung/laser/abspreizgabel_steg.dxf

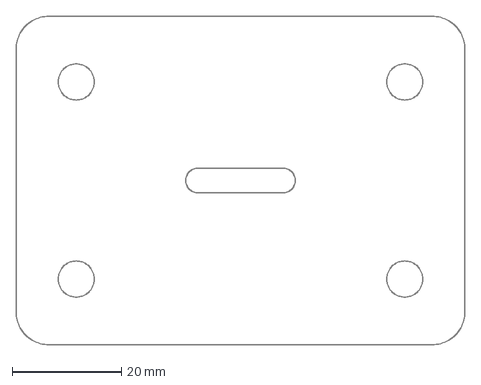
[picture p53: CAD file, 2026-11-02]
fertigung/laser/abspreizgabel_steg.dxf
82.0 x 60.0 mm
