Michael314as/Exoskelett/fertigung/laser/lagerplatte.dxf

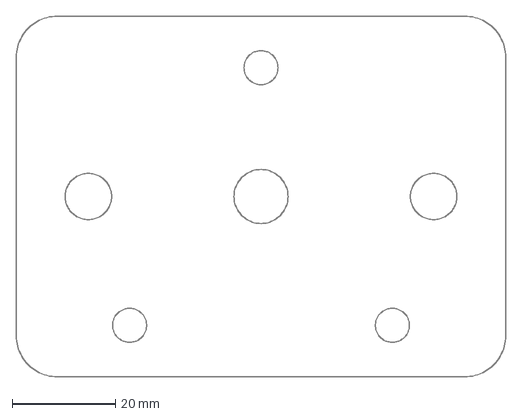
[picture p54: CAD file, 2026-11-02]
fertigung/laser/lagerplatte.dxf
95.0 x 70.0 mm
