Michael314as/Exoskelett/fertigung/laser/steigbuegel_seitenlasche.dxf

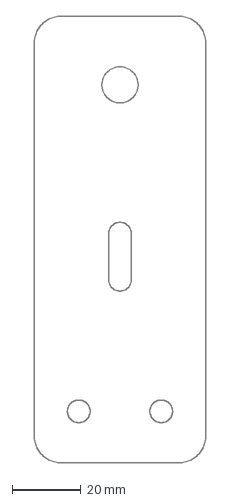
[picture p55: CAD file, 2026-10-31]
fertigung/laser/steigbuegel_seitenlasche.dxf
50.0 x 130.0 mm
