Michael314as/Exoskelett/(list of files, cad)

Other CAD files:
fertigung/druck/tastergriff_rechts.stl
