Michael314as/Exoskelett/(commit log)

2026-10-29 Use Case 1 (Christbaum aufladen) mit interaktiver 3D-Darstellung
    - README: Ablauf in sechs Schritten, Annahmen, erste Lastschätzung,
    offene Fragen, Sicherheit und nächste Schritte
    - visualisierung/use-case-christbaum.html: three.js-Szene mit Person im
    aktiven Exoskelett, Christbaum und Plateau (0–1,75 m). Plateauhöhe,
    Baumlänge, Körpergröße und Einnetzen sind einstellbar; die Lastanzeige
    schätzt Greifer-, Schulter-, Hüft- und Kniemomente durch den Baum.
    Claude-Session: https://claude.ai/code/session_011XXTwDwpKZy33tq57zXy7h
2026-10-29 Ablauf umgestellt: Baum fast senkrecht tragen statt waagrecht
    Waagrecht nur am Schnittende gehalten erzeugt der Baum ein großes
    Kippmoment (2 m: 73 Nm, 3 m: 309 Nm) – über Kopf und beim Gehen nicht
    praktikabel. Neuer Ablauf: greifen, fast senkrecht aufrichten und
    zurücklehnen, tragen, auf die Plateaukante kippen, aufschieben, loslassen.
    - Kinematik: Neigung beim Tragen 78°, Zurücklehnen aus Baumgewicht und
    Schwerpunkt, Auflage auf Kante bzw. Plateau beim Ankippen/Aufschieben,
    Baum legt sich nach dem Loslassen ganz aufs Plateau
    - Lastmodell: Kippmoment nach Neigung; liegt der Baum auf, trägt das
    Plateau mit. Tragen jetzt 15 statt 73 Nm am Greifer (2 m Baum)
    - Äste drücken sic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
2026-10-29 Aufladen ohne Schieben: lotrecht hochheben und 90° umkippen lassen
    Statt den Baum auf die Kante zu kippen und aufs Plateau zu schieben
    (kann den Baum beschädigen), wird er fast lotrecht hochgehoben, bis das
    Schnittende auf Plateauhöhe ist, knapp hinter der Kante abgesetzt und
    kippt dann 90° aufs Plateau.
    - Kinematik: Hochheben auf 84°, Abstand zur Kante solange die Äste unter
    der Ladefläche wären (inkl. Vorneigung), Absetzen 8 cm hinter der
    Kante, Umkippen um das Schnittende; sobald die untersten Äste
    aufliegen, hebt sich das Schnittende und der Greifer öffnet
    - Greifer als Scharnier beim Umkippen: kein Moment, das Plateau trägt
    - Reicht die Körpergröße nicht, bleibt der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
2026-10-30 Vorgaben eingearbeitet: 1,75 m, Bäume 1–4 m ungenetzt, Gleichgewicht
    - Körpergröße 1,75 m als Standard, Baumlänge bis 4 m, Einnetzen entfernt
    (Bäume sind nicht eingenetzt), Greiferlast in kg statt N
    - Neue Prüfung Gleichgewicht: gemeinsamer Schwerpunkt aus Körper und
    Baumlast (inkl. Kippmoment) muss über dem Fußballen bleiben;
    Statusanzeige zeigt jetzt mehrere Hinweise gleichzeitig und nennt den
    Schritt, in dem es kritisch wird
    - Sonne/Schatten und Kamera passen sich an lange Bäume an
    - Nach dem Umkippen legt sich der Baum auch dann ganz auf seine Äste,
    wenn das Schnittende etwas zu tief abgesetzt wurde
    - README: Festlegungen, Kennzahlen für 1,75 m und Bäume 1–4 m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
2026-10-30 Auslegung „so kräftig wie möglich“: Gewicht frei, Exo einstellbar
    - Baumgewicht unabhängig von der Länge einstellbar (1–150 kg), folgt der
    Länge nur, bis man es selbst setzt
    - Körpergewicht (75 kg), Gewicht des Exos (Hälfte am Rücken, Hälfte an
    den Beinen) und nach vorne verlängerte Fußplatten gehen ins
    Gleichgewicht ein; die Fußplatten sind im 3D-Modell sichtbar länger
    - Kippt es beim Aufrichten, schlägt die Seite die Leiter-Methode vor
    - README: Ziel und Festlegungen, Auslegungsfälle bis 4 m / 120 kg
    (Hochschwenken gegen alles andere), Vergleich mit dem Stand der
    Technik, erster Entwurf der Anforderungen A1–A10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
2026-10-30 Aufrichten mit zwei Händen, Ziel Kraftverdopplung, Use Case 2 Ziehen
    - Rechte Hand am Stumpf als Drehpunkt, linke Hand weit Richtung Spitze als
    Hebel; zurücklehnen und den Baum in die Senkrechte bringen. Die linke
    Hand bleibt beim Tragen oben und greift zum Hochheben nach unten
    - Lastanzeige: Hebelkraft der linken Hand statt Kippmoment im Greifer
    - README: Technik, Ziel „Bewegung unterstützen, bis doppelte Kraft“,
    Hebelkräfte nach Baumgröße, Use Case 2 (schwere Lasten ziehen) als offen
    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
2026-10-30 Use Case 2: Bäume schleifen mit Zuggreifer an der Hüfte
    Kräfte für 1 bis 4 Bäume (angehoben gegen schleifend), Erklärung warum
    man ohne Exo rückwärts geht, Vorschlag Zuggreifer hinten am Hüftrahmen
    und Anforderungen Z1 bis Z4.
    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
2026-10-30 3D-Skizze Use Case 2: Bäume schleifen
    Einfache Szene zum Abgleich: mit Exo vorwärts (Zuggreifer hinten an der
    Hüfte, Gewicht über Rahmen und Beine) gegen ohne Exo rückwärts (Stümpfe
    in den Händen, zurückgelehnt). Anzahl, Länge, Gewicht je Baum und Boden
    einstellbar, grobe Kräfte daneben.
    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
2026-10-30 Konzept Entwurf 1: Rückenantrieb mit Seilzügen
    Grundstruktur (Rückenrahmen, Hüfte, Bein- und Armschienen, Fußplatten mit
    Snowboard-Bindung), sechs Motorkanäle mit Seilübertragung (Beinseil über
    Hüfte und Knie, Schultern, Ellbogen), Gasfedern fürs Halten, mechanisch
    selbstklemmende Greifer, Steuerung, Akku, Sicherheit, Kosten und Ausbaustufen.
    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
2026-10-30 3D: Exo laut Konzept, beide Use Cases in einer Szene
    - Exo neu: Kraxen-Rückenrahmen, Antriebsbox mit sechs Motoren und
    Stihl-Akku, Dyneema-Seile über Rollen an Hüfte, Knie, Schultern und
    Ellbogen, Gasfedern an den Schultern, Fußplatten mit Bindung (vorne
    18 cm, hinten 8 cm länger), Klemmgabel rechts
    - Use Case 2 (Schleifen) als zweites Szenario: Zuggreifer pendelnd hinter
    der Hüfte, 1 bis 4 Bäume, Gras oder Schnee, Lasten und Gleichgewicht
    nach hinten; ersetzt die einfache Skizze
    - Konzept Entwurf 2: Stihl-Akku, Wetterfestigkeit, geschraubte Bauweise
    ohne Drehteile, nur Ein/Aus, Greifer-Vergleich, Gewichtsabwägung
    C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
2026-10-30 Entwurf 3: Schlaufengreifer, Sensor-Manschetten, Bowdenzüge, Steigbügel, Kraftverteilung
    - Zuggreifer und Klemmgabel gestrichen; Schlaufengreifer (2 je Unterarm, einzeln per Winde)
    - Steuerung über Kraftsensoren in den Manschetten (docs/steuerung.md)
    - Arme in beide Richtungen über Bowdenzug-Paare und Seilscheiben, Gasfedern gestrichen
    - Steigbügel mit Spikes statt langer Fußplatten (Schlamm, Gelände)
    - Kraftverteilung gerechnet (tools/kraftverteilung.py, docs/kraftverteilung.md)
    - 3D-Konstruktion überarbeitet: realistischere Teile, Live-Steuerungsdemo, Kraftfluss-Ansicht
    - Use-Case-Seite, README, Konzept und Entwicklungsplan auf Entwurf 3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
2026-10-30 Entwurf 3.1: Schlaufen am Handgelenk, Hüft-Abspreizgelenk, Kurvenscheiben
    - Schlaufen kommen am Handgelenk nach unten heraus (rechts 2, links 1), Stamm längs als Armverlängerung
    - Hüfte: freies Abspreizgelenk und Drehlager, Füße seitlich beweglich
    - Beinseil um Umlenkscheibe auf der Hüftachse und Kurvenscheibe am Knie (Seil kommt nie ans Gelenk)
    - Schulter mit offenem Seilpaar statt Bowdenzug
    - Kraftverteilung, Konzept, Steuerung, README und beide 3D-Seiten angepasst
    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
2026-10-31 Entwurf 3.2: Bedienung, Komfort-Features, Fertigung ohne Maschinen, Plantage-Umgebung
    - docs/bedienung-und-features.md: Hochwertigkeit, Features im Budget, Bedienkonzept, Fertigung, Kosten
    - 3D: Parkstütze, Arbeitslicht, LED-Ring mit Display, Magnet-Schnallen, Schnellkupplungen, Haube
    - 3D: verschneite Plantage in der Dämmerung mit Schneefall, Werkstatt umschaltbar, eloxierte Oberfläche, Rundgang
    - README, Konzept und Entwicklungsplan verlinkt
    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
2026-10-31 Stückliste mit Herstellweg je Teil, Druckgrößen-Prüfung und Werkzeugliste
    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
2026-10-31 Ablauf-Seite Entwurf 3.2: Plantage in der Dämmerung, Ausfallschritt, Arbeitslicht, Baumzähler
    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
2026-10-31 Firmware: Steuerungskern, Gesamtsteuerung, Teensy-Anbindung, Physik-Simulation mit Abnahmetests
    - Gelenkregler mit Reibungsausgleich, Totband, Tiefpass, Rampen, Grenzen; Sicherheits-Zustandsmaschine
    - Bedienung (kurz/lang/doppelt), Schlaufenwinden, LED-Ring, Licht, Baumzähler
    - Simulation: Transparenz, Verstärkung 1/(1+K), Stabilitätsreserve, Weichheit, Fehlerreaktion
    - Fix aus der Simulation: weniger Dämpfung, kleineres Totband, Stufenwechsel öffnet keine Schlaufen mehr
    - CI-Workflow führt die Tests bei jeder Firmware-Änderung aus
    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
    [exo_app.h, exo_core.h, main_teensy.cpp, sim_test.cpp]
2026-10-31 Firmware: Motor- und Wägezellen-Treiber, Teensy-Anbindung, Test-Build des Teensy-Codes
    - drivers.h: MIT-CAN-Protokoll (AK70-10-Klasse), HX711, Kalibrierung, Seilübersetzung; mit Tests
    - main_teensy.cpp: CAN-Motoren, 8 Wägezellen, Motoren einschalten
    - teensy_host.cpp + Platzhalter: Teensy-Code kompiliert und läuft auf dem PC (make test)
    - Fix: fehlendes initializer_list-Include in exo_app.h
    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
    [drivers.h, exo_app.h, main_teensy.cpp, sim_test.cpp, teensy_host.cpp]
2026-10-31 Firmware baut für Teensy 4.1 (ARM-GCC): Einstellungen im EEPROM, Werkstatt-Konsole, IMU, LED-Ring, Watchdog
    - Pinplan ohne Doppelbelegung; Display und Handy über ESP32-C3 (Statuszeile), damit der Regeltakt nie blockiert
    - Motoren erst nach dem Hochfahren hinter dem Schütz einschalten (sonst sofort Fehler beim Einschalten)
    - EEPROM nur schreiben, wenn das Exo aus ist; Wartungshinweise aus Betriebsstunden
    - tools/build_teensy.sh baut ohne IDE/PlatformIO; CI baut die Hex-Datei
    - Tests: Prüfsumme, Kalibrierung, Konsole, Statuszeile
    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
2026-10-31 Fertigungsdateien: 18 Laserteile (DXF), 12 Druckteile (STL), Teileliste, automatische Prüfung
    - tools/fertigung.py erzeugt alles parametrisch und prüft geschlossene Konturen, Mindeststege je Bohrung,
    verschmolzene Bohrungen, wasserdichte Druckteile und den Bauraum des A1 mini
    - Prüfung hat Fehler gefunden und behoben: Seilklemmen-Bohrung am Rand, Erleichterungslöcher Ellbogenscheibe,
    Steigbügel-Aussparungen durch den Rand, Spikes an der Sohlenspitze, Rastloch Parkstütze
    - fertigung/README.md: Bestellen, vom Kaufteil abhängige Maße, Drucken
    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
    [abspreiz_lasche.dxf, bohrschablone_rohr20.stl, bohrschablone_rohr25.stl, eckplatte.dxf, haube_links.stl, haube_rechts.stl, knie_kurvenscheibe_bord.dxf, knie_kurvenscheibe_rille.dxf]
2026-10-31 Produktionsdokumentation: Verdrahtung, Montage, Prüf- und Abnahmeprotokoll, Risikobeurteilung, Wartung, Reifegrad; ESP32-C3 für Display und Handy
    - docs/verdrahtung.md: Leistung, Sicherungen, Pinplan (= Firmware), CAN-IDs
    - docs/montage.md: Montage, Inbetriebnahme, Kalibrierung mit der Werkstatt-Konsole
    - docs/pruefung.md: 33 Prüfpunkte mit messbaren Kriterien
    - docs/risikobeurteilung.md: Gefährdungen nach ISO 12100, Normen für den Verkauf
    - docs/wartung.md und Wartungshinweise in der Firmware (40/100/200 h)
    - docs/produktionsreife.md: Stand mit Nachweisen und Weg zur Serie
    - esp32/: Display und BLE, Statuszeilen-Auswertung getestet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
2026-10-31 firmware/README: Stand aktualisiert (Teensy-Build, Einstellungen, ESP32, was noch fehlt)
    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
2026-10-31 Prüfstand-Modus, Messdaten-Log und Parameterbestimmung
    - Konsole: pruefstand/voll (nur Ellbogen rechts aktiv), log 0/1 (t, q, qd, Kraft, Moment mit 200 Hz)
    - tools/auswertung.py bestimmt Trägheit, Reibung und Schwerkraft aus dem Log; geprüft mit Simulations-Log
    bekannter Werte (make -C firmware ident, alle innerhalb 20 %)
    - Montage, Prüfprotokoll (F4, P14b), Reifegrad und CI ergänzt
    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
2026-10-31 Doku: automatische Prüfpunkte und Firmwaregröße aktualisiert
    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
2026-10-31 ESP32-Sketch auf dem PC mit Platzhaltern bauen und testen; Neuzeichnen bei neuem Fehlergrund
    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
2026-11-01 Entwurf 4: Hüfte mit Abspreizgelenk und Hüftmotor (Mischweg), Beine in beide Richtungen, Gurtsystem, Schlaufen unten + außen, Anzeige am Oberarm
    - 3D-Konstruktion: Abspreizgelenk hinter dem Hüftgelenk mit Hüftschwinge und Zentrierfedern,
    Hüftmotor mit Seilgetriebe 1:6, Knie per Bowdenzug-Paar mit Federpatrone, Schienen durchgehend
    bis in Knie- und Knöchellager, Kippgelenk hinter der Ferse, Gurtsystem, Schlaufenträger,
    Anzeige am rechten Oberarm, Bein-Demo im Live-Panel
    - Firmware: 8 Gelenke, Kopplung der Manschetten über die Hebel, Vorsteuerung aus Baumlast
    (Wägezellen in den Schlaufenköpfen) und Körpergewicht, Standbein/Schwungbein über Fußkontakt,
    Statuszeile mit Uh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
2026-11-01 3D-Konstruktion: Umlenkrollen richten sich nach dem Seil aus, Elektronik und Kabelbäume komplett, Ansichten mit Durchsicht
    - Seilwege der Schulter und der Schlaufenwinden über Rollen im Rollenbock, Achse senkrecht zur Seilebene, Seil tangential, Rollenböcke an Rahmen bzw. Träger befestigt
    - Box: Hauptplatine mit Teensy und CAN-Transceiver, Windentreiber, Spannungswandler, Kupferschiene mit Sicherungen, Motorleitungen, CAN-Kette, Akkuleitung, Rundstecker
    - Kabelbäume zu Hüftmotoren, Bein-Sensoren, Armen, Anzeige, Licht und Not-Aus
    - Ansichten Komplett/Mechanik/Antrieb/Elektronik, Regler 'Rahmen durchsichtig', Schalter Gurte und Hauben (Hüftmotor-Hauben neu)
    - Tabelle Leistung und Gefü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
2026-11-01 Konstruktion: Festigkeit und Rohrgrößen, zwei Akkus links/rechts mit Schutzbügel, Motoren nach Zugweg, Schulter seitlich schwenkbar, Schlaufengreifer als Spannband mit neuer Bedienung
    - tools/festigkeit.py + docs/festigkeit.md: Biegespannungen, neue Profile (Hüftschwinge 35x35x3, Schulterbügel 30x30x3, Schienen 30/25)
    - zwei Akkuschächte neben der Box, Ideal-Dioden-Modul, Schutzbügel mit Gummipuffern, Parkstütze hinten
    - Motorreihen: Knie unten, Ellbogen Mitte, Schulter oben
    - Schulter: Abspreizgelenk hinter dem Schultergelenk, Schulterschwinge, Seile durch die hohle Achse, Regler 'Arme seitlich'
    - Seilbögen an Schulter und Ellbogen in den lokalen Scheibenebenen
    - Schlaufe als Feder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
2026-11-01 Technische 3D-Ansicht (exo-technik.html): Bauteilbaum mit IDs, reale Kaufteile, Inspektor, Bewegung nach Motorkennlinie, Gelenktabelle, Schwerpunkt und Standfläche, Maße, Schnitt, Normansichten; Kons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
2026-11-01 Technische Ansicht vervollständigt: Gehen mit abwechselnden Beinen (Phase begrenzt durch Motorkennlinie), Stückliste mit Stückzahlen und Massen, Stückzahlen im Schwerpunkt, Zuordnung aller Körper gep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
2026-11-01 Technische Ansicht: Datenblattwerte mit Quellen (AK70-10, AP 500 S, Liros D-Pro, 5840-31ZY), stärkerer Bandantrieb, Motorkennlinie aus Nenn- und Leerlaufpunkt, Ausbalancieren durch Rumpfvorneigung, z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
2026-11-01 Technische Ansicht: Fußkontakt mit 50-kg-Wägezellen statt FSR 406, Spannungswandler nach Datenblatt (Winden nacheinander), Teensy-Maße; Quellen ergänzt
    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
2026-11-02 Firmware: Wärmeschutz der Motoren (Leistungsabsenkung), Sturzdämpfung der Beine, automatische Lendensperre bei Last, Warnung bei Rückwärtsneigung (Pin 13 Hubmagnet). Technische Ansicht: Gasfedern und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
2026-11-02 Fertigung auf Entwurf 4: 32 Laserteile (Abspreizgabel, Hüftmotorplatte, Seilscheibe Ø120, Knie-Kurvenscheibe 45–155°, Beugescheibe, Steigbügel, Drehteller, Lendengelenk mit Rastsegment, Schultergabel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
    [abspreiz_lasche.dxf, abspreizgabel_steg.dxf, abspreizgabel_wange.dxf, akkuschacht_stirn.stl, akkuschacht_wand.stl, drehteller_scheibe.dxf, eckplatte.dxf, fersenbuegel_lasche.dxf]
2026-11-02 Steuerung: Reaktionszeit und Upgrade-Weg ADS1220 dokumentiert
    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
2026-11-02 Konzeptzeichnung: Lendengelenk mit Gasfedern und Sperre (neuer Bauteil-Eintrag), Fingerschutz, Drehteller, Drehring, Schulterschlitten; Use-Case-Seite auf Entwurf 4 (34 kg, Hüftmotoren statt Beinseil)
    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
2026-11-02 Gewicht: Parkstütze abnehmbar (bleibt am Fahrzeug), Schutzbügel CFK, dünnere Hauben und Box: 34 → 32,5 kg ohne Abstrich an Sicherheit; Use-Case-Seite und Doku angepasst
    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
2026-11-02 Bestellliste Prototyp: alle Teile nach Bezugsweg mit Quellen, Bestellreihenfolge in 5 Stufen (Prüfstand und Schlaufe zuerst, um Schätzwerte früh zu messen)
    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
2026-11-02 Bestellliste: Stufe 1 (Prüfstand) und 2 (Schlaufe) mit recherchierten Preisen, ≈ 850 €
    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
2026-11-02 Bauteilliste: Zählfehler behoben (Schultergurte, Hauben dreifach; zweiter Akku und Parkstütze in der Summe), Exo 31,1 kg; Firmware trägt im Stand 25 kg Exo-Oberteil statt 11 kg (sonst 14 kg selbst ge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
    [exo_app.h]
2026-11-02 Vorsteuerung Hüfte: Exo-Oberteil 21,5 kg mit Schwerpunkt 8 cm hinter der Hüftachse getrennt vom Menschen gerechnet (aufrecht kein Zug nach hinten an den Schultergurten); technische Ansicht zeigt Mass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
2026-11-02 Schätzwerte mit Quellen bis zur Messung: Schlaufe ≈ 150 N Schließkraft / > 400 N Haltekraft (Händler-Datenblätter 5840-31ZY statt 100 N), Motorwärme AK70-10, Reaktionszeit vs. Literatur, Gewicht; wid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
2026-11-02 Reale Kaufteile in der technischen Ansicht: Hersteller, Typ, Kenndaten und Quellen je Teil (Motoren, Akku, Elektronik, Sensoren, Seile, Bowdenzüge, Lager, Gasfeder, Hubmagnet, Relais, Stecker, Schäke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
    [abspreizgabel_steg.dxf, abspreizgabel_wange.dxf, drehteller_scheibe.dxf, eckplatte.dxf, fersenbuegel_lasche.dxf, gasfeder_halter.dxf, hueftmotor_platte.dxf, kippgelenk_gabel.dxf]
2026-11-02 Kosten aktualisiert: Material ≈ 5.100–6.800 € je Exo (Motoren nach Händlerpreisen 3.000–4.600 €, Windentreiber, Hubmagnet, IMU korrigiert)
    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
2026-11-02 Motoren: RobStride RS06 statt CubeMars AK70-10 (11/36 Nm statt 8,3/24,8 Nm, gleiche Drehzahl bei 36 V, gleicher Bauraum, ≈ halber Preis). Firmware: RobStride-CAN-Protokoll (29-Bit-ID, Typ 1/2/3/4), W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
    [abspreizgabel_steg.dxf, abspreizgabel_wange.dxf, drehteller_scheibe.dxf, eckplatte.dxf, fersenbuegel_lasche.dxf, gasfeder_halter.dxf, hueftmotor_platte.dxf, kippgelenk_gabel.dxf]
2026-11-02 Entwurf 5 Firmware: Gelenkkapseln mit RobStride RS04 (Hüfte, Knie, Schulter) und RS03 (Ellbogen), Übersetzung 1:1, Wertebereiche je Motormodell, Dauermoment in der Kapsel für den Wärmeschutz, Frostsc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
2026-11-02 Entwurf 5, technische Ansicht: Gelenkkapseln (RS04 an Hüfte, Knie, Schulter; RS03 am Ellbogen), Schubstangen-Parallelogramme an Knie und Ellbogen mit Federpaket, Kapselhauben mit Dichtung und Heizung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
2026-11-02 Fertigung Entwurf 5: Motorträger RS04/RS03, Wangen, Abtriebsflansch, Kurbeln und Hebel (Knie, Ellbogen), Kapselhauben (Druck), Kurbelschutz; Seilscheiben, Kurvenscheiben, Motorplatten und Fingerschut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
    [abspreizgabel_steg.dxf, abspreizgabel_wange.dxf, abtriebsflansch_rs04.dxf, drehteller_scheibe.dxf, eckplatte.dxf, ellbogenhebel.dxf, fersenbuegel_lasche.dxf, fingerschutz_ellbogen.stl]
2026-11-02 Entwurf 5 Doku: Konzept (Gelenkkapseln, Gewicht 37,2 kg, Kosten 4.700–5.600 €), Stückliste, Bestellliste neu erzeugt (Stufe 1 mit RS04-Kapsel), Steuerung, Risiken, Prüfpunkte P35–P37 (Dichtheit, Fros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
2026-11-02 Use-Case-Seite: Exo-Gewicht 37 kg (Entwurf 5)
    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
2026-11-02 Wärmemanagement der Gelenkkapseln: Stiftkühlkörper (Fischer ICK S R 140) direkt auf dem Motorgehäuse statt gedämmter Haube, dünner Kapselmantel mit O-Ringen, Heizband an der Abtriebsseite; Dauermomen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
    [abspreizgabel_steg.dxf, abspreizgabel_wange.dxf, abtriebsflansch_rs04.dxf, bohrschablone_kuehlkoerper_rs03.stl, bohrschablone_kuehlkoerper_rs04.stl, drehteller_scheibe.dxf, eckplatte.dxf, ellbogenhebel.dxf]
2026-11-02 Rumpfdrehung ±15° (Bogenführung um die Wirbelsäule mit Profilrollen, Zentrierfedern, Anschlägen) und kompakter Rucksack: Akkus stehend oben im Schutzbügel (von oben einstecken), flache Elektronikbox 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
    [abspreizgabel_steg.dxf, abspreizgabel_wange.dxf, abtriebsflansch_rs04.dxf, drehteller_scheibe.dxf, eckplatte.dxf, ellbogenhebel.dxf, fersenbuegel_lasche.dxf, gasfeder_halter.dxf]
2026-11-02 Rumpf motorisiert: Beugen mit RS04 (Schubstange zum Lendengelenk, 80/20 Nm) und Drehen mit RS03 (Kurbel zur Bogenführung, ±30 Nm), beide in Kühlkörper-Kapseln hinter dem Kreuzbein; 4 Rumpf-Wägezellen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
    [abspreizgabel_steg.dxf, abspreizgabel_wange.dxf, abtriebsflansch_rs04.dxf, drehteller_scheibe.dxf, eckplatte.dxf, ellbogenhebel.dxf, fersenbuegel_lasche.dxf, gasfeder_halter.dxf]
2026-11-03 Manschetten M2: Mitgehen-Regelung statt reiner Kraftverstärkung
    - Firmware: Admittanz (v_soll = admit · Kraft) mit Dämpfung im Motor (RobStride Typ 1, packMitCommand),
    Schwingungswächter (> 6 Hz), Grenzen auf das Gesamtmoment, quadratischer Auslauf vor Anschlägen
    - 500 Hz Regeltakt, zwei CAN-Busse (CAN1/CAN3), 3 × ADS131M04 (1000/s) für Manschetten und Rumpf,
    Schienbein-Manschetten (17 Wägezellen, Einstellungen v6), Pinplan neu
    - Tests: Transparenz Ellbogen/Schulter/Knie über 2–15 kN/m, Störfälle, Wächter, Treiber; Studie tools/transparenz.cpp
    - Mechanik: breite PETG-CF-Schale, 4-mm-Viskopolster, BOA-Drehverschluss, Längsschlitten ±12 mm;
    3D-Modell (44,3 kg), Fertigung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
    [manschette_oberarm.stl, manschette_oberschenkel.stl, manschette_schienbein.stl, manschette_schlitten.dxf, manschette_stangenhalter.dxf, manschette_unterarm.stl, manschette_unterschenkel.stl]
2026-11-03 Mitgehen nachgeschärft: 8 rad/s Mitgehgrenze, 0,9 rad/s je N; Tests für Schätzfehler und schnellen Schwung
    - Simulation fand: bei schneller Schwungbewegung (1,4 Hz ±34°) half das Mitgehen kaum (21–23 N), weil
    die Geschwindigkeitsgrenze 4 rad/s war. Jetzt 8 rad/s an den Gliedern (Rumpf 2): Schulter 4,8 N, Knie 9,7 N
    (Rest = Sicherheitsgrenze 10 Nm Knie-Beugen, ohne sie 4,9 N)
    - neue Tests: Trägheit/Reibung ×0,5…×2 falsch geschätzt bleibt unter 5 N
    - Teensy-4.1-Build mit ARM-GCC geprüft (102 KB, keine Warnung im eigenen Code)
    - Doku: Ergebnisse, Knie-Beugegrenze als Abwägung, was die Simulation belegt und was erst der Prüfstand zeigt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
2026-11-03 Steuerung: Entscheidung festgehalten (Knie-Beugegrenze 10 Nm bleibt, Simulation als Planungsnachweis, echter Nachweis mit P39)
    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
2026-11-07 Knie: Trägheit aus der Bauteilliste (0,18 statt 0,25 kg·m²), Kd 2,1; schneller Schwung 4,7 N statt 9,7 N
    Die 10-Nm-Beugegrenze bleibt; mit der realen Trägheit von Unterschenkel und Fuß reicht sie auch für
    schnelle Schritte. Tests, Doku angepasst, Teensy-Build geprüft.
    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
2026-11-07 Prüfstand-Werkzeug fürs Mitgehen (P39): Log je Gelenk mit Mitgeh-Größen, Auswertung mit Einstellvorschlag
    - Konsole: `pruefstand <gelenk>` und `log 1 <gelenk>` (0–9, ohne Angabe Ellbogen rechts)
    - Log: zusätzlich v_soll, Kd, Gesamtmoment, Motormoment aus der Rückmeldung, Schwingungswächter, Schwinganteil
    - tools/auswertung.py: Identifikation mit dem echten Motormoment (beim Mitgehen fehlte sonst der Kd-Anteil),
    Bewertung der Manschettenkraft in Bewegung und der Wächter-Eingriffe, Vorschlag kdJoint/admit/Reibung/Schwerkraft
    - log_demo erzeugt Logs mit Mitgehen (gut / Störung / zu träge); make ident prüft Werte und Vorschlag in allen drei Fällen
    - Doku: montage.md Abschnitt 6 u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
2026-11-07 Konzeptzeichnung auf Entwurf 5 mit Manschetten M2
    - Gelenkkapseln (Motor im Mantel, Stiftkühlkörper, Abtriebsflansch) an Hüfte und Schulter direkt auf der Achse,
    an Knie und Ellbogen oben am Glied mit Kurbel, Schubstange (Parallelogramm 1:1) und Gelenkhebel; Federpaket im Knie
    - zwei Rumpfkapseln hinter dem Kreuzbein, kompakter Rucksack: Akkus stehend oben, flache Elektronikbox in Lendenhöhe
    - Manschetten M2 (breite Schale, BOA, Längsschlitten), jetzt auch am Schienbein; Seile, Bowdenzüge, Antriebsbox entfernt
    - Texte, Leistungstabelle, Legende, Kraftfluss, Werkbank (Kapsel zerlegt, Manschette M2) neu
    Claude-Session: https://cl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
